CollinYan/HPV-2017-EE/Mechanical/brake actuation/20171115_224807.jpg

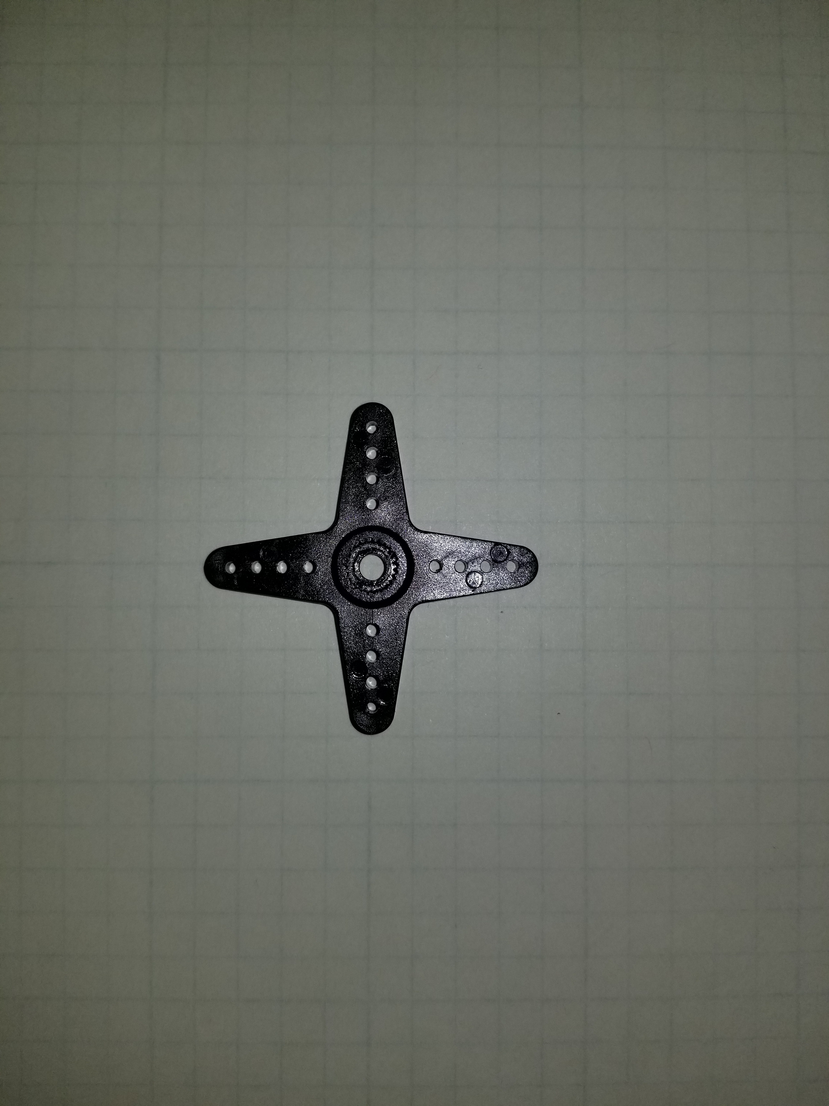
Mechanical/brake actuation/20171115_224807.jpg
