CollinYan/HPV-2017-EE/block diagram distributed power.docx

Battery

E-stop

Lever Lock

Tilt Lever

Brake Lever

Tilt-Lock

6V Buck

Rear Brakes

3.7V Buck

6V Buck

Arduino
