CollinYan/HPV-2017-EE/block diagram.docx

6V Buck

Battery

3.7V Buck

Lever Lock

Arduino

E-stop

Tilt-Lock

Tilt Lever

Rear Brakes

Brake Lever
