CollinYan/HPV-2017-EE/Breadboard_Template.pdf

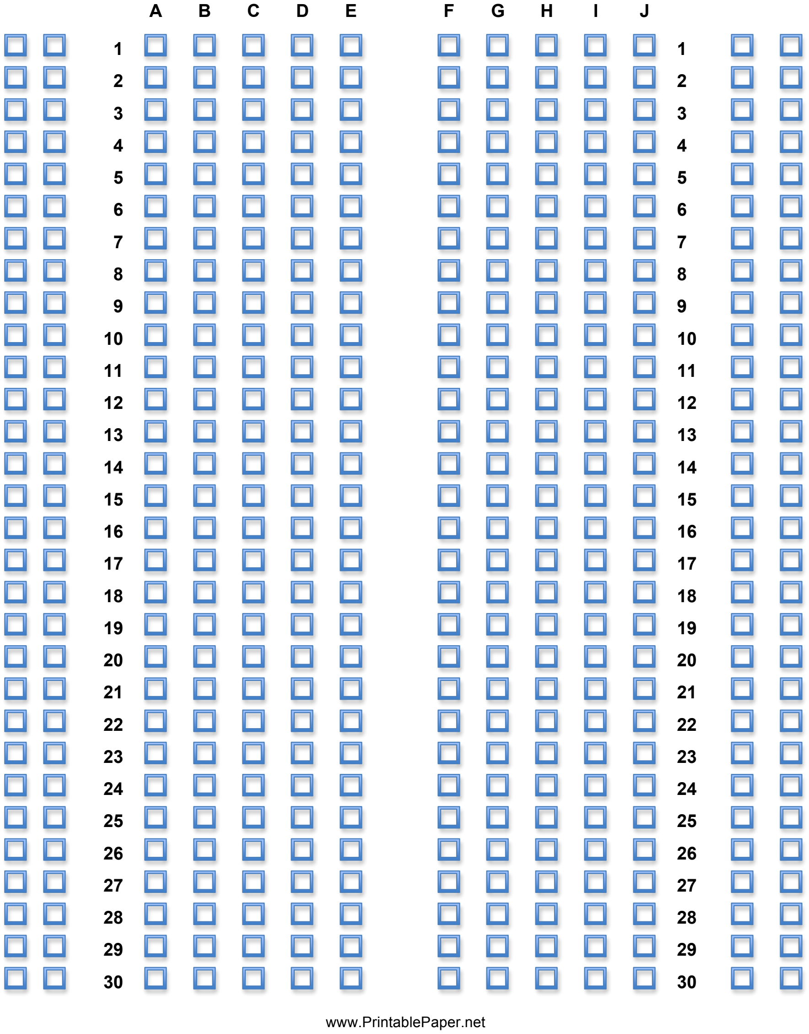
[picture p4: page 1]

A | B | C | D | E | F | G | H | I | J

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
10 10
11 11
12 12
13 13
14 14
15 15
16 16
17 17
18 18
19 19
20 20
21 21
22 22
23 23
24 24
25 25
26 26
27 27
28 28
29 29
30 30

www.PrintablePaper.net
