CollinYan/HPV-2017-EE/Code/README.docx

Go to preferences, and change sketchbook locatain to the dropbox folder

We can now keep all our libraries together

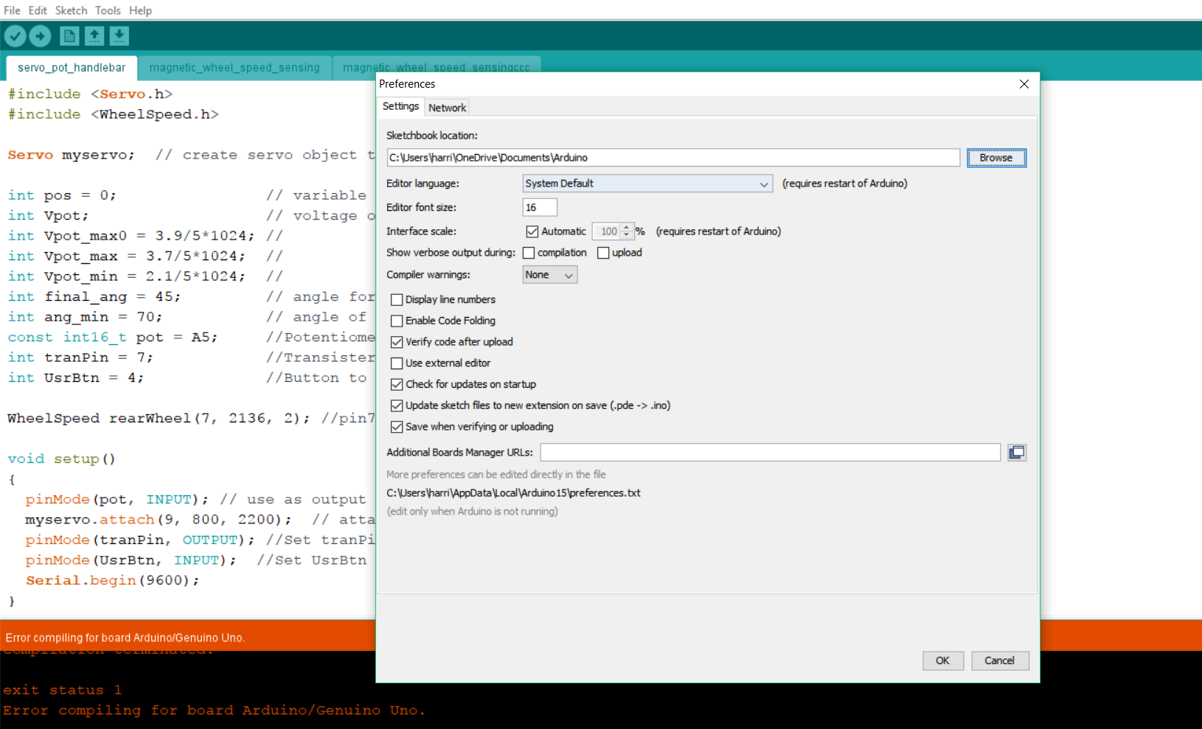
[picture p5: figure]

Change to:

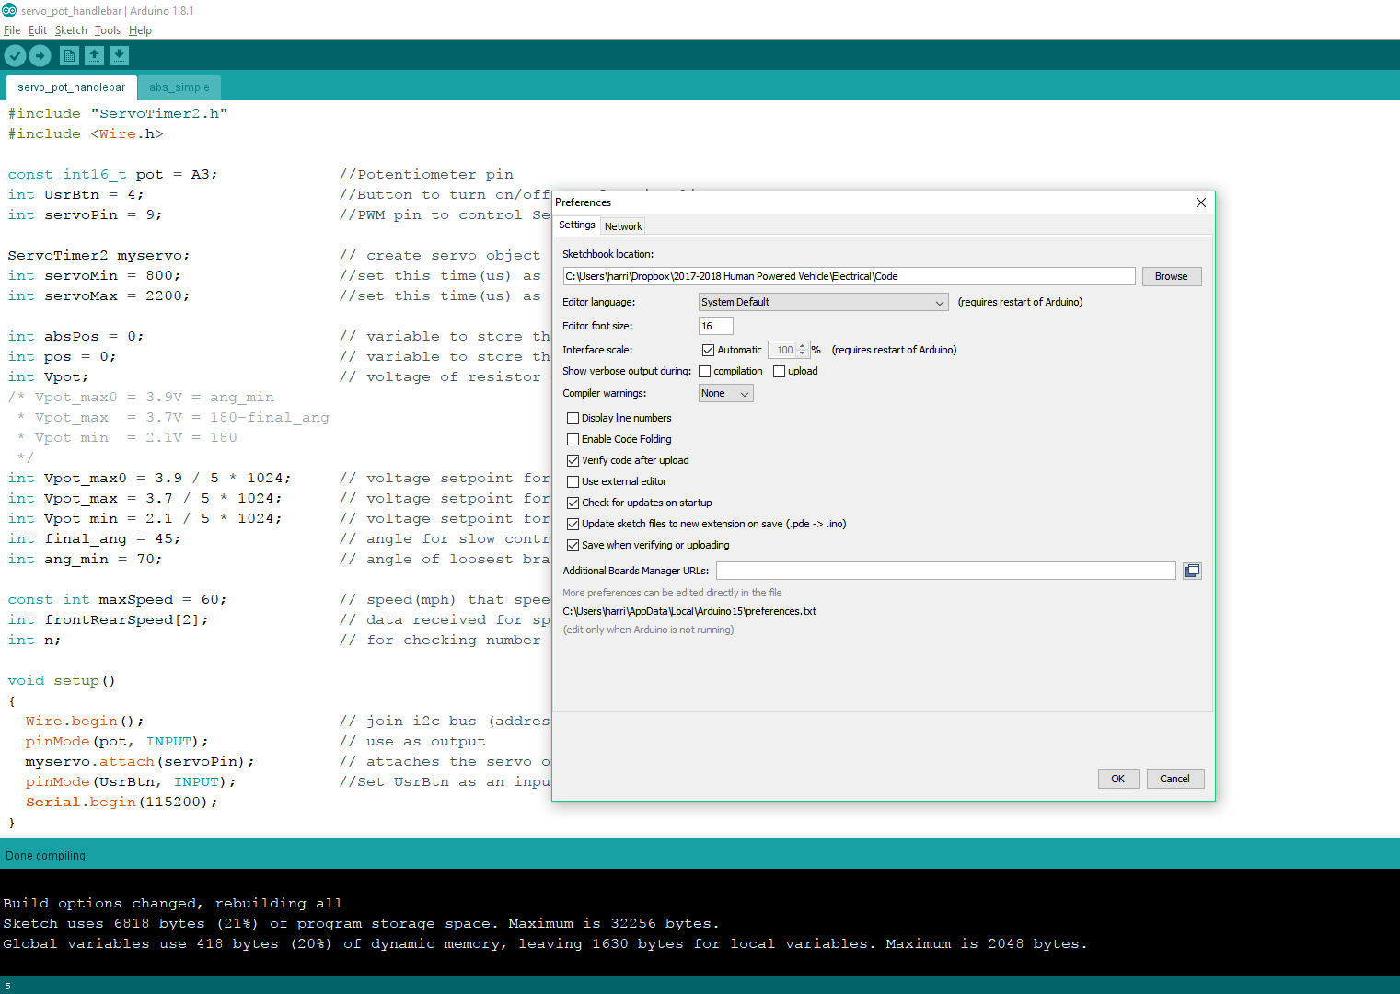
[picture p6: figure]
