CollinYan/HPV-2017-EE/data/16 magnets rear high speed.png

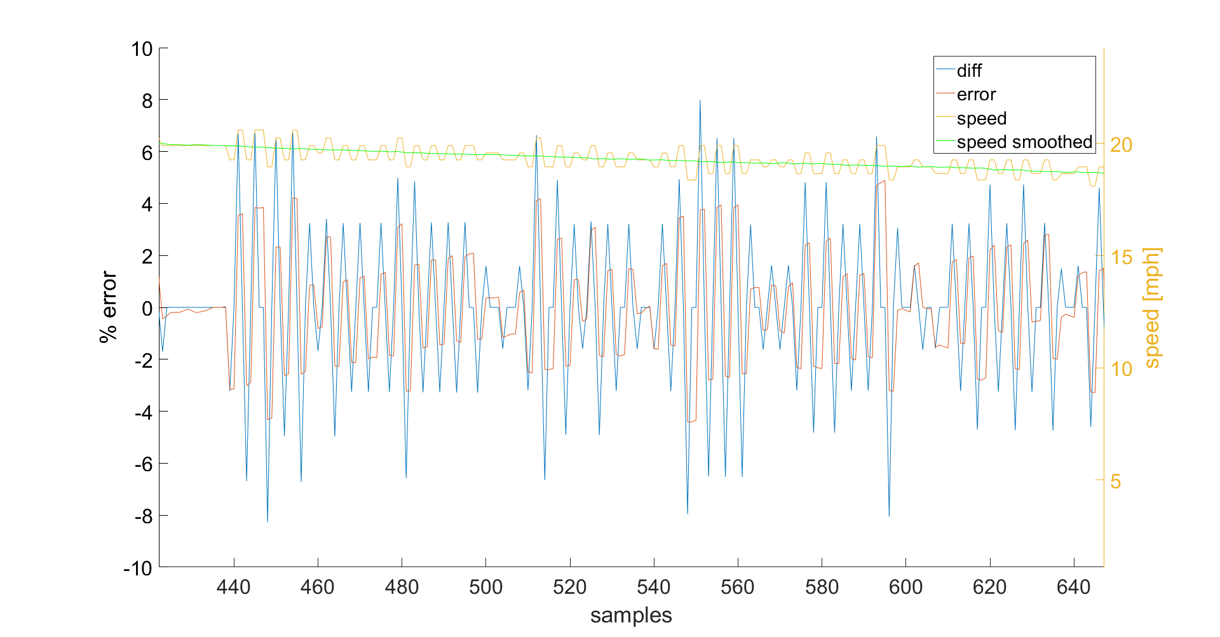
data/16 magnets rear high speed.png
