CollinYan/HPV-2017-EE/data/16 magnets rear low speed.png

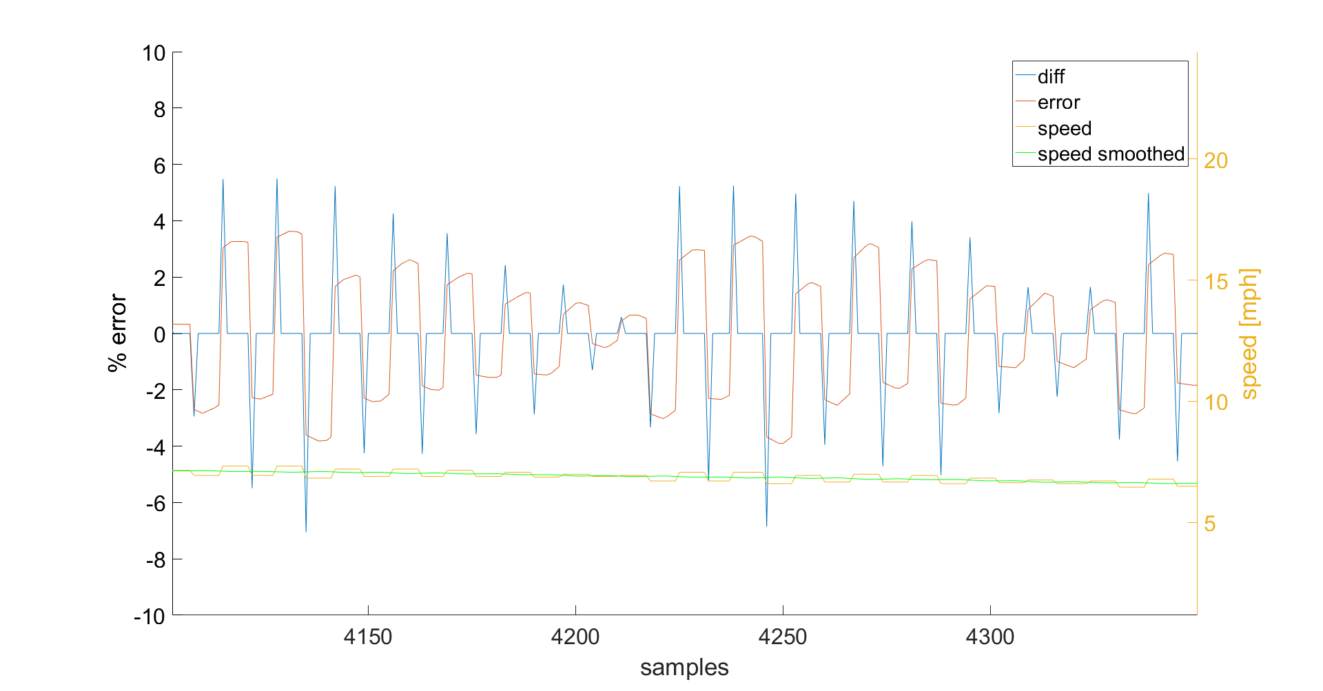
data/16 magnets rear low speed.png
