CollinYan/HPV-2017-EE/data/16 magnets rear.png

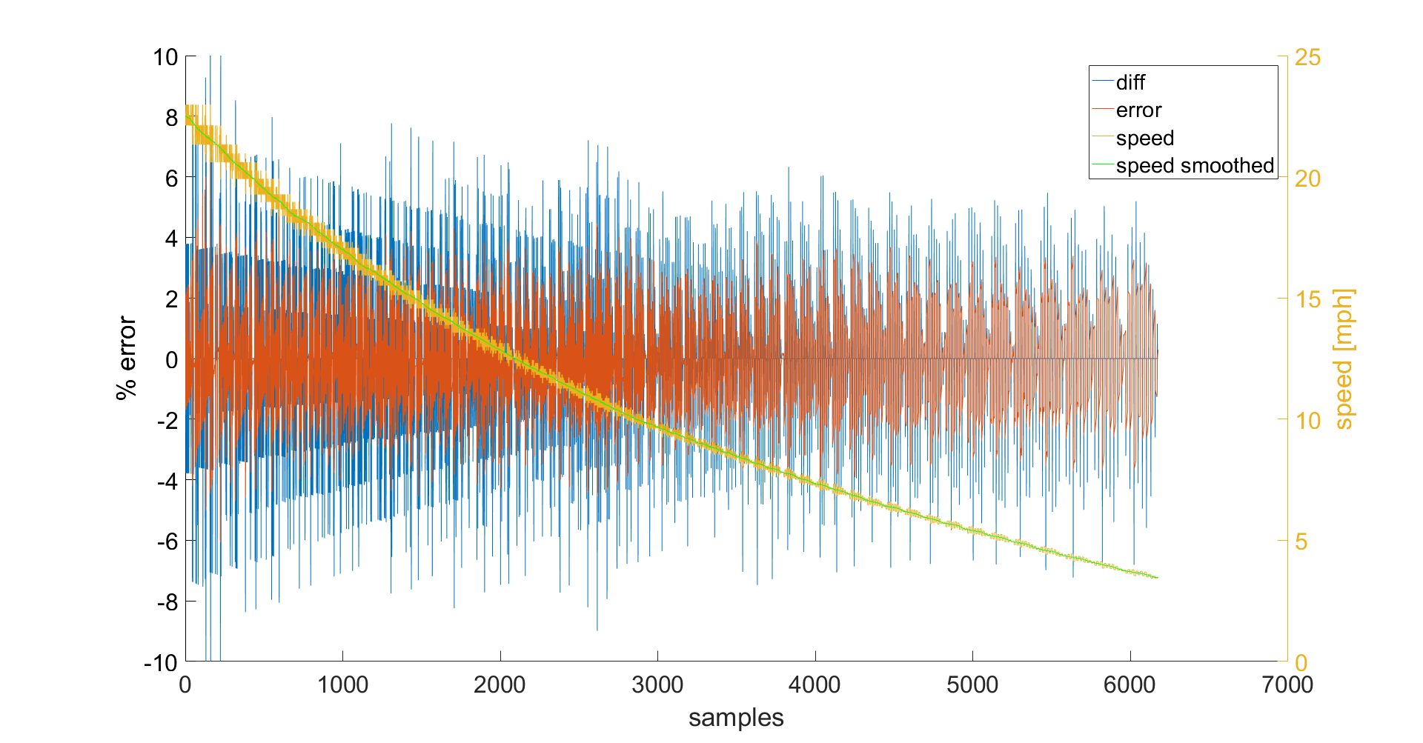
data/16 magnets rear.png
