CollinYan/HPV-2017-EE/PCB/smallerArduino101/images/layout.png

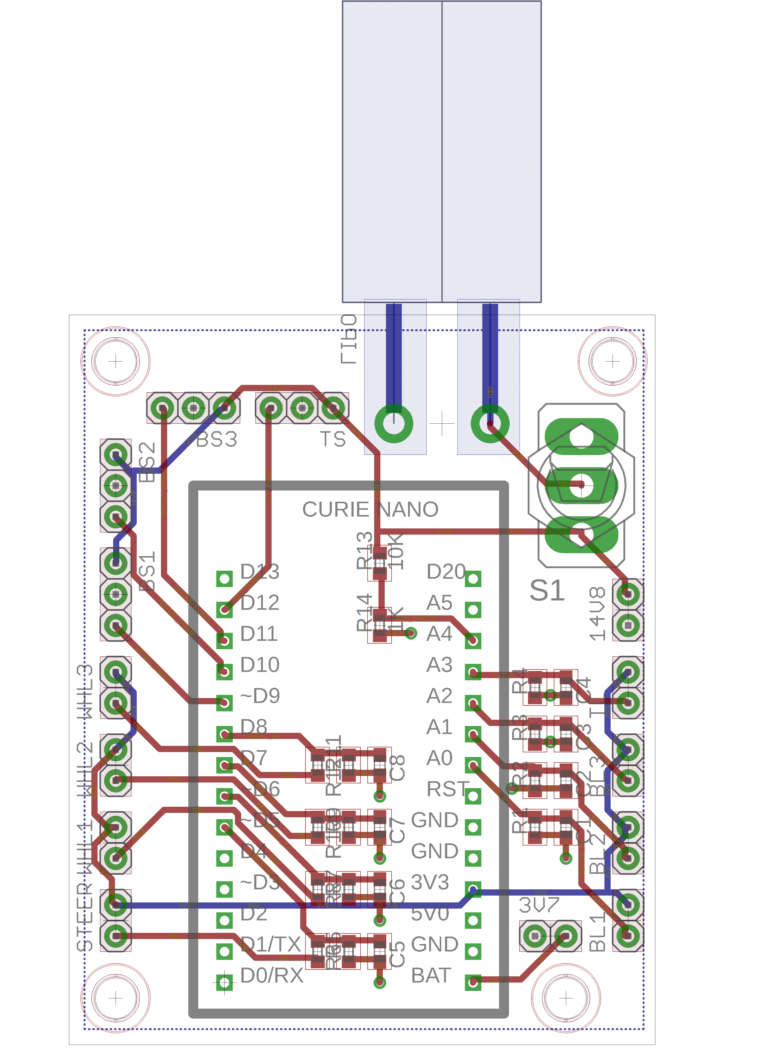
PCB/smallerArduino101/images/layout.png
