CollinYan/HPV-2017-EE/PCB/smallerArduino101/images/schem.png

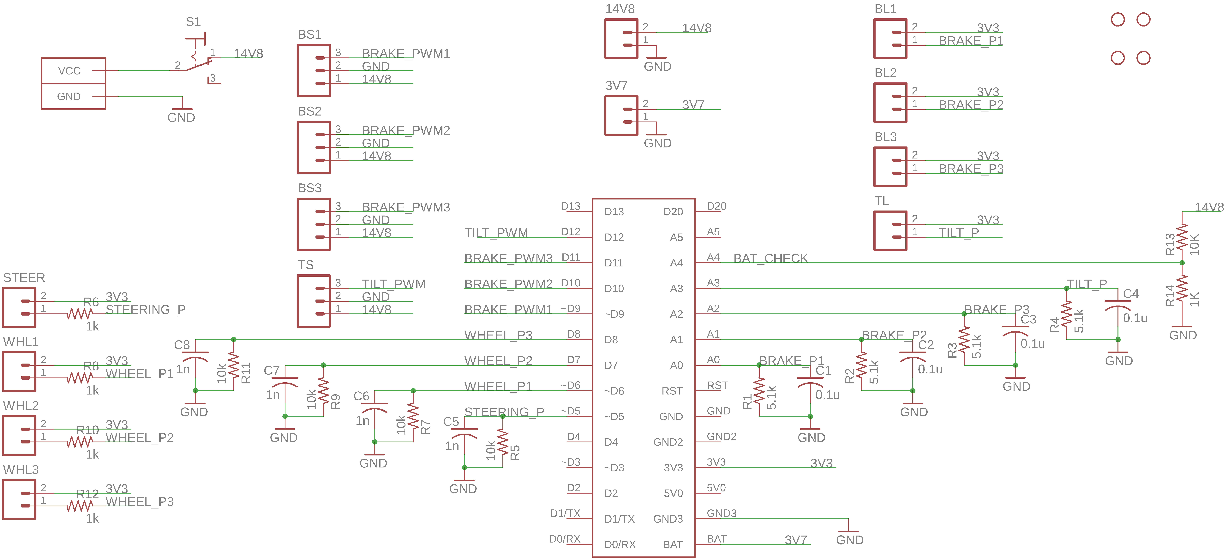
PCB/smallerArduino101/images/schem.png
