CollinYan/HPV-2017-EE/pics/cateye reed switch bounce_1.jpg

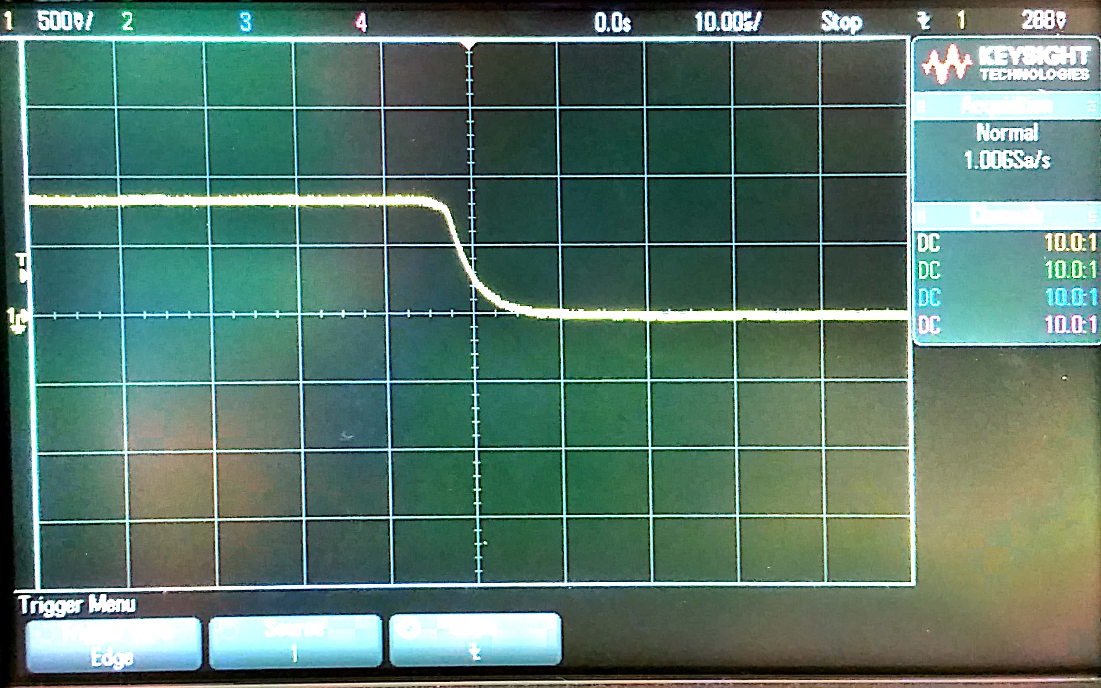
pics/cateye reed switch bounce_1.jpg
