CollinYan/HPV-2017-EE/pics/cateye reed switch bounce_2.jpg

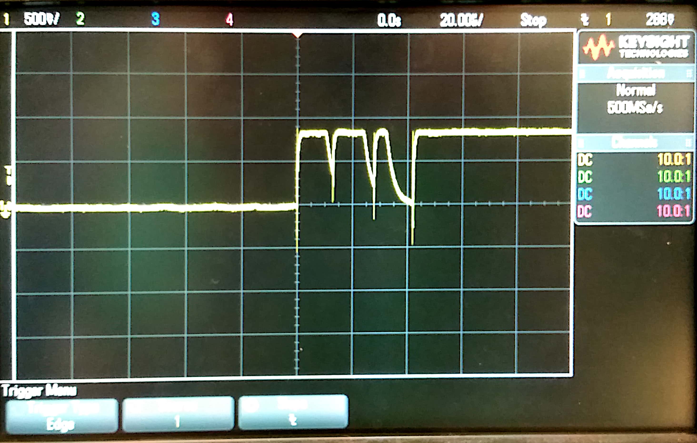
pics/cateye reed switch bounce_2.jpg
