CollinYan/HPV-2017-EE/pics/cateye reed switch bounce_3.jpg

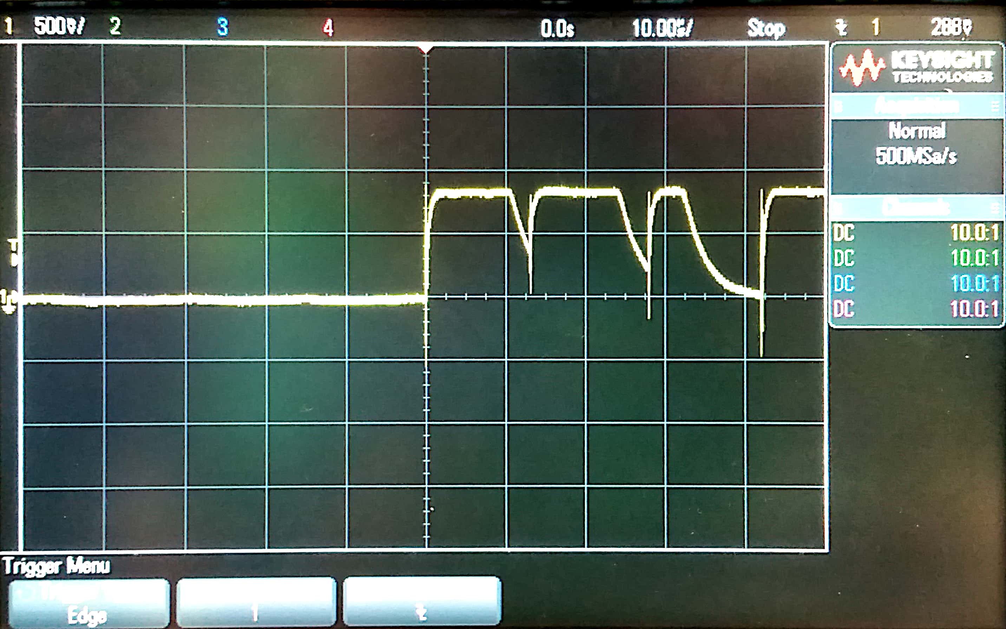
pics/cateye reed switch bounce_3.jpg
