CollinYan/HPV-2017-EE/pics/prototype disc.jpg

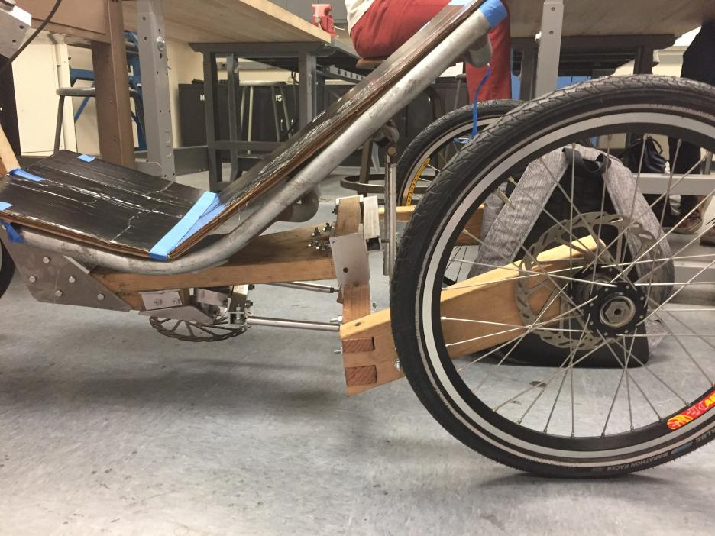
pics/prototype disc.jpg
