CollinYan/HPV-2017-EE/Mechanical/3dprint/brake lever p2.stl

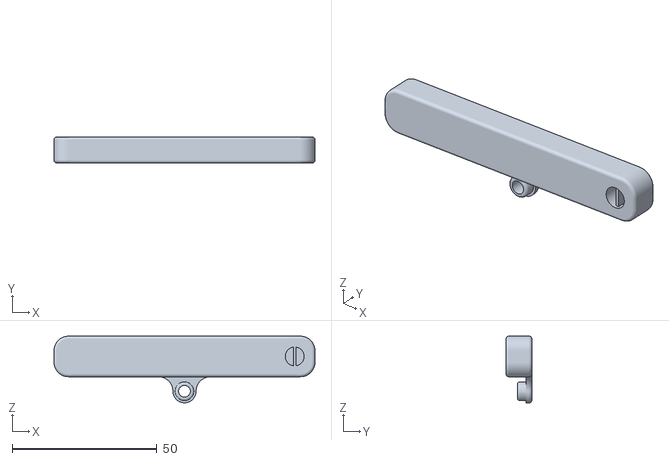
[picture p17: CAD file, 2018-02-09]
Mechanical/3dprint/brake lever p2.stl
90.0 x 9.00 x 23.0
