CollinYan/HPV-2017-EE/Mechanical/3dprint/kevin print feb 5/Enclosure.stl

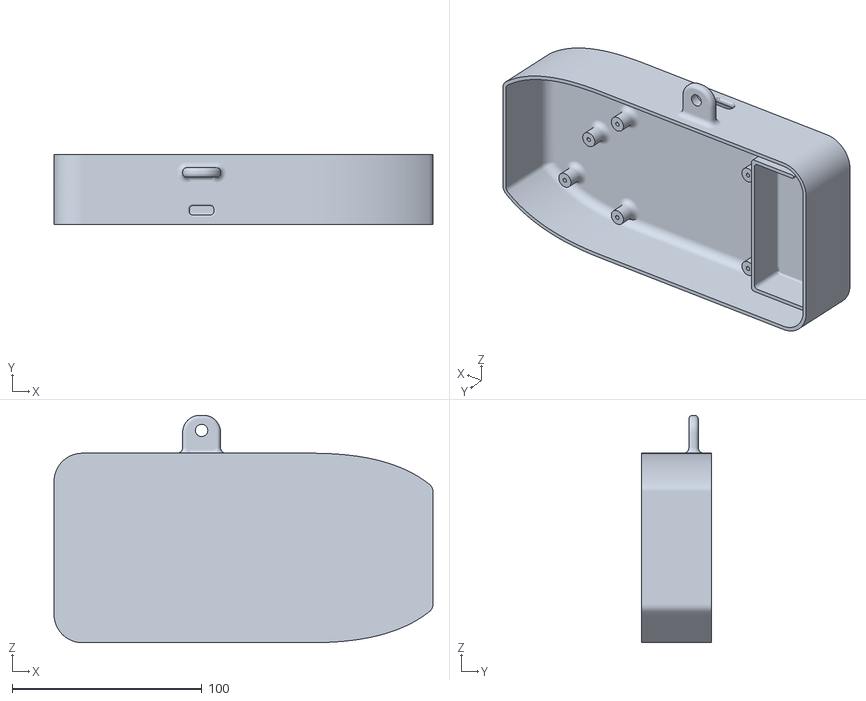
[picture p18: CAD file, 2018-02-09]
Mechanical/3dprint/kevin print feb 5/Enclosure.stl
200.0 x 37.0 x 120.0
