CollinYan/HPV-2017-EE/Mechanical/brake actuation/offset magnet.stl

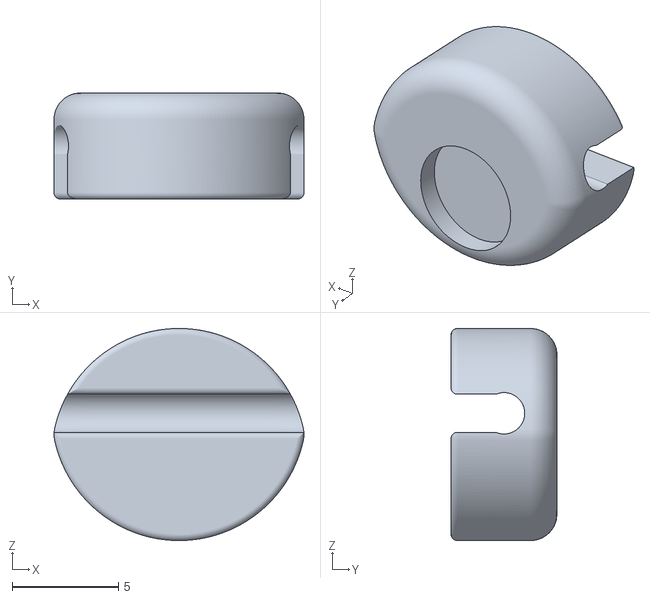
[picture p19: CAD file, 2018-03-03]
Mechanical/brake actuation/offset magnet.stl
11.8 x 5.00 x 10.00
