CollinYan/HPV-2017-EE/Mechanical/brake actuation/servo horn adaptor 20mm]/top horn adaptor.stl

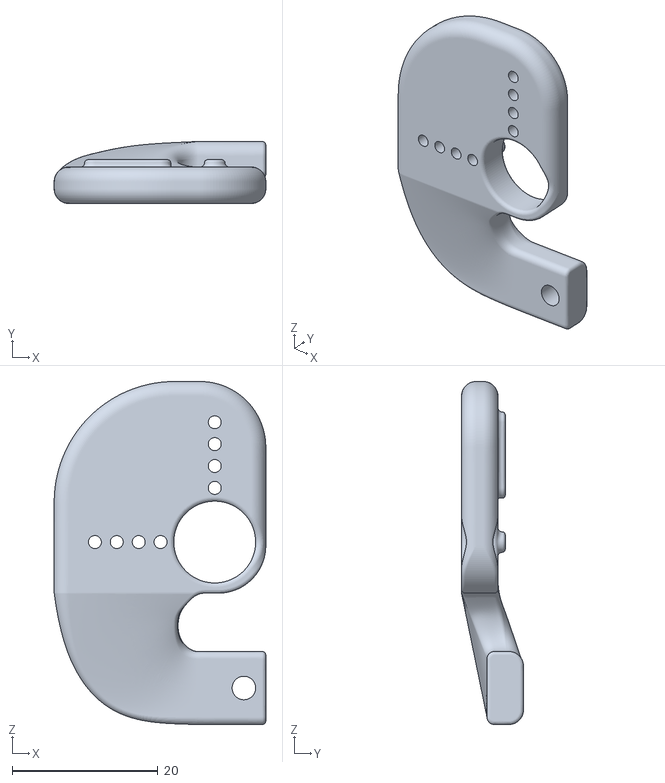
[picture p20: CAD file, 2018-03-02]
Mechanical/brake actuation/servo horn adaptor 20mm]/top horn adaptor.stl
29.0 x 8.50 x 47.0
