CollinYan/HPV-2017-EE/Mechanical/buck converter enclosure.stl

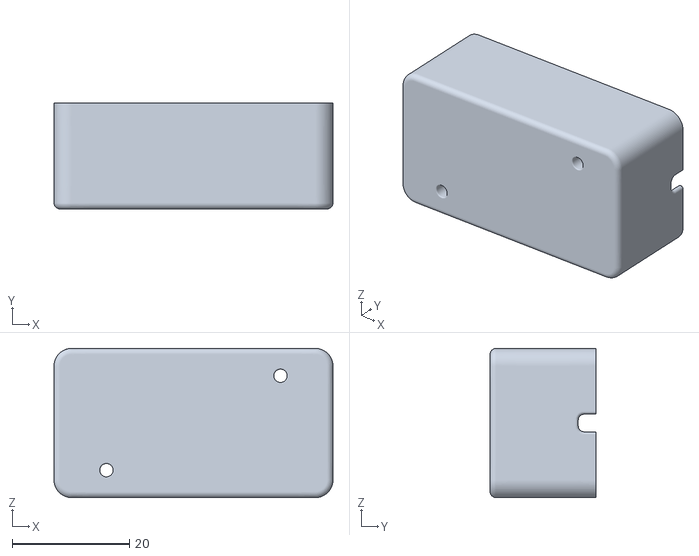
[picture p21: CAD file, 2018-02-27]
Mechanical/buck converter enclosure.stl
47.5 x 18.0 x 25.4
