CollinYan/HPV-2017-EE/Mechanical/3dprint/brake lever p1.stl

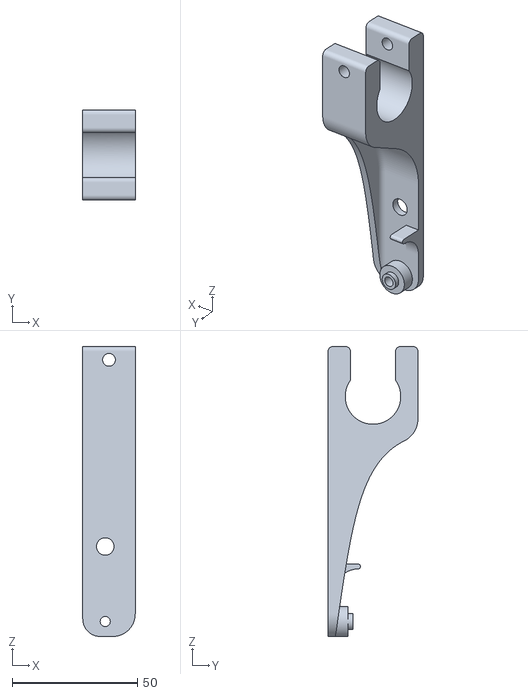
[picture p22: CAD file, 2018-02-09]
Mechanical/3dprint/brake lever p1.stl
21.0 x 36.0 x 116.0
