CollinYan/HPV-2017-EE/Mechanical/brake actuation/servo horn adaptor 20mm]/bottom horn adaptor.stl

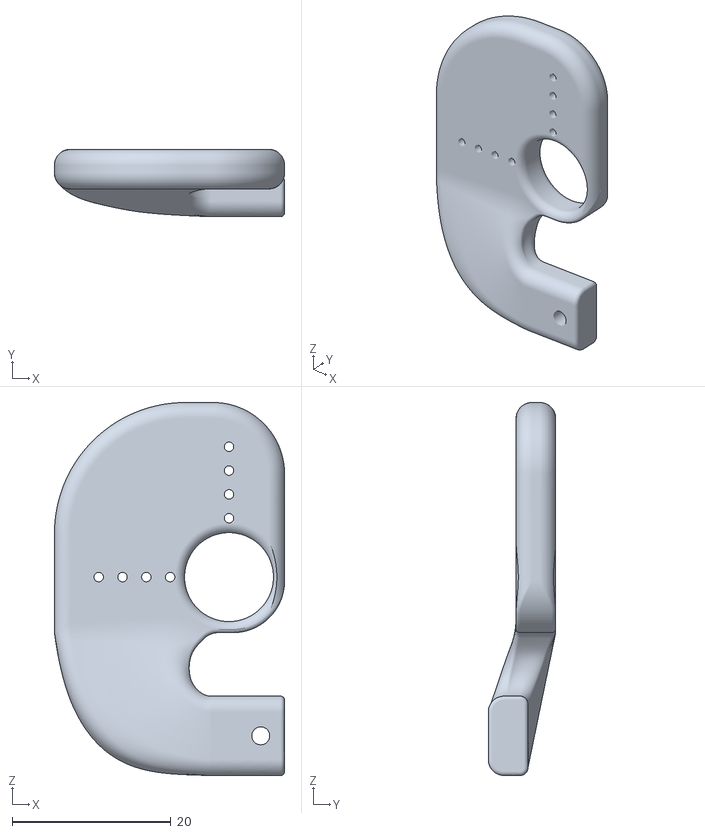
[picture p23: CAD file, 2018-03-02]
Mechanical/brake actuation/servo horn adaptor 20mm]/bottom horn adaptor.stl
29.0 x 8.50 x 47.0
