CollinYan/HPV-2017-EE/Mechanical/brake actuation/servo horn.STEP

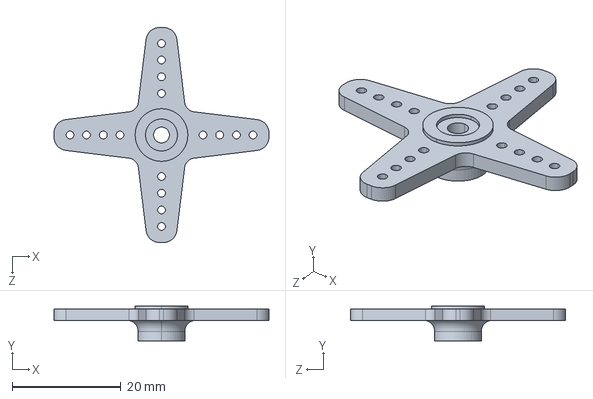
[picture p24: CAD file, 2018-01-30]
Mechanical/brake actuation/servo horn.STEP
39.6 x 6.43 x 39.6 mm
