CollinYan/HPV-2017-EE/Mechanical/buck converter enclosure lid.stl

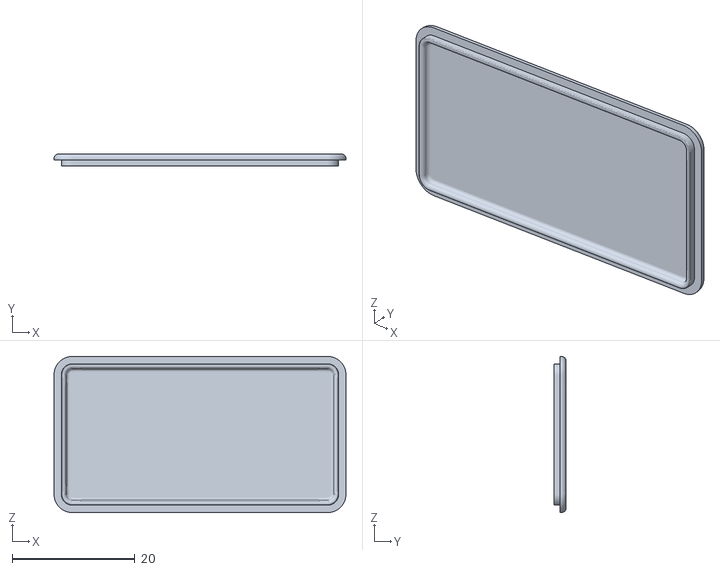
[picture p25: CAD file, 2018-02-27]
Mechanical/buck converter enclosure lid.stl
47.5 x 2.00 x 25.4
