CollinYan/HPV-2017-EE/Mechanical/3dprint/magnetholder v4.stl

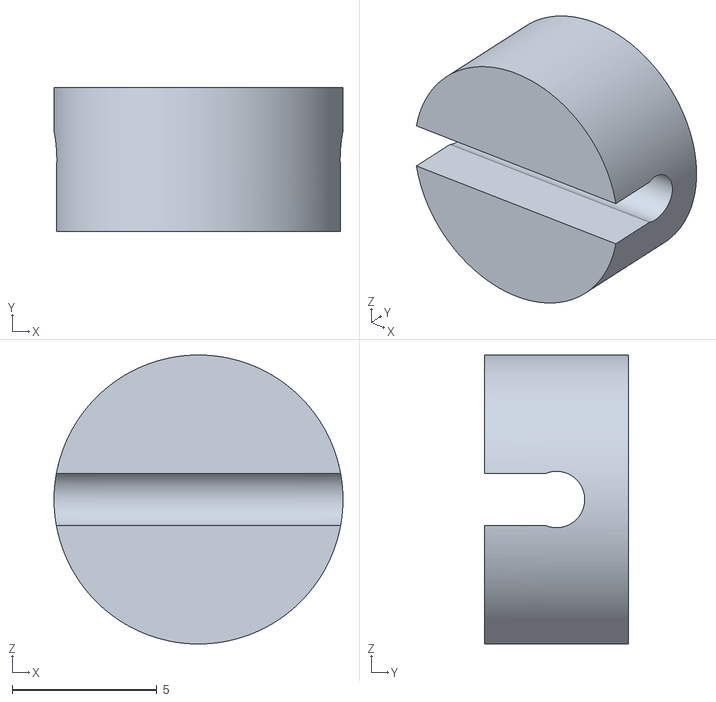
[picture p26: CAD file, 2018-01-30]
Mechanical/3dprint/magnetholder v4.stl
10.0 x 5.00 x 10.00
