CollinYan/HPV-2017-EE/Mechanical/brake actuation/new servo mount with coutnerbore for cory printing.stl

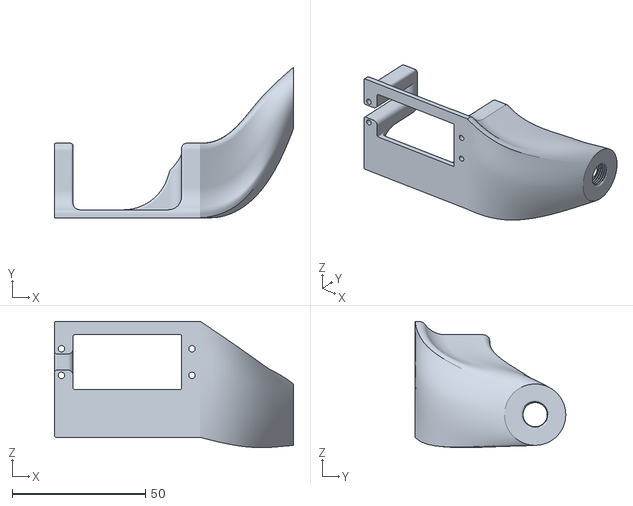
[picture p27: CAD file, 2018-01-30]
Mechanical/brake actuation/new servo mount with coutnerbore for cory printing.stl
89.7 x 56.5 x 47.4
