CollinYan/HPV-2017-EE/Mechanical/brake actuation/servo horn adaptor 20mm]/magnet holder.stl

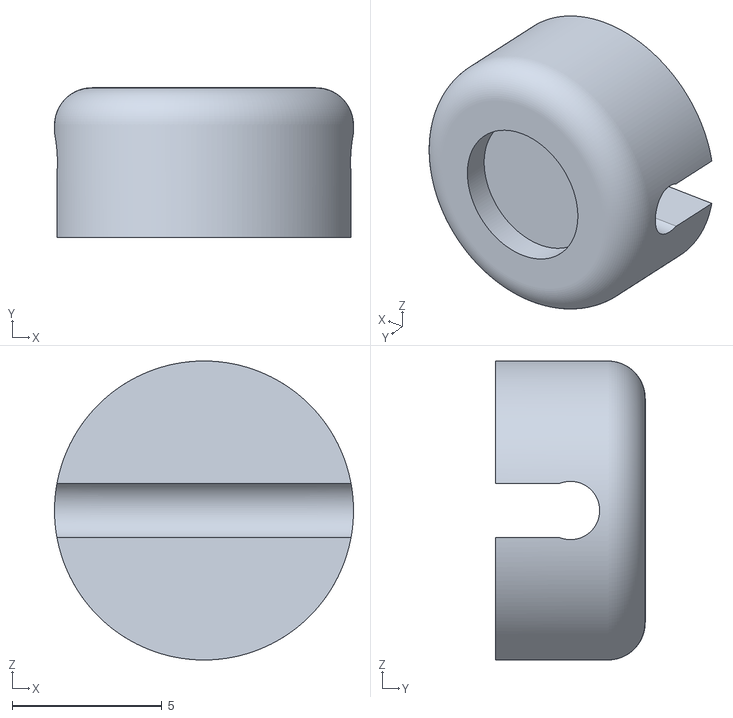
[picture p28: CAD file, 2018-03-02]
Mechanical/brake actuation/servo horn adaptor 20mm]/magnet holder.stl
10.0 x 5.00 x 10.00
