CollinYan/HPV-2017-EE/Mechanical/enclosure.stl

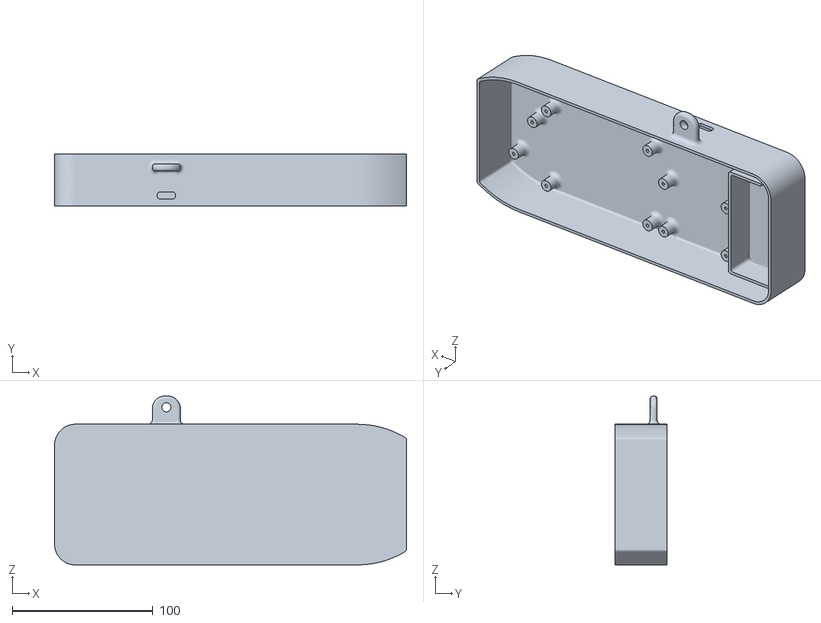
[picture p29: CAD file, 2018-02-09]
Mechanical/enclosure.stl
250.0 x 37.0 x 120.0
