CollinYan/HPV-2017-EE/Mechanical/3dprint/kevin print feb 5/Enclosure Lid.stl

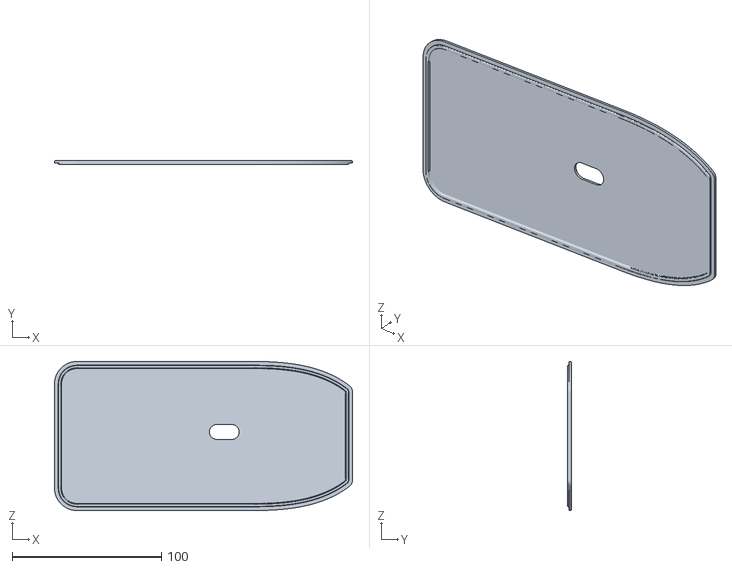
[picture p30: CAD file, 2018-02-09]
Mechanical/3dprint/kevin print feb 5/Enclosure Lid.stl
200.0 x 3.00 x 100.0
