CollinYan/HPV-2017-EE/Mechanical/brake actuation/servo.STEP

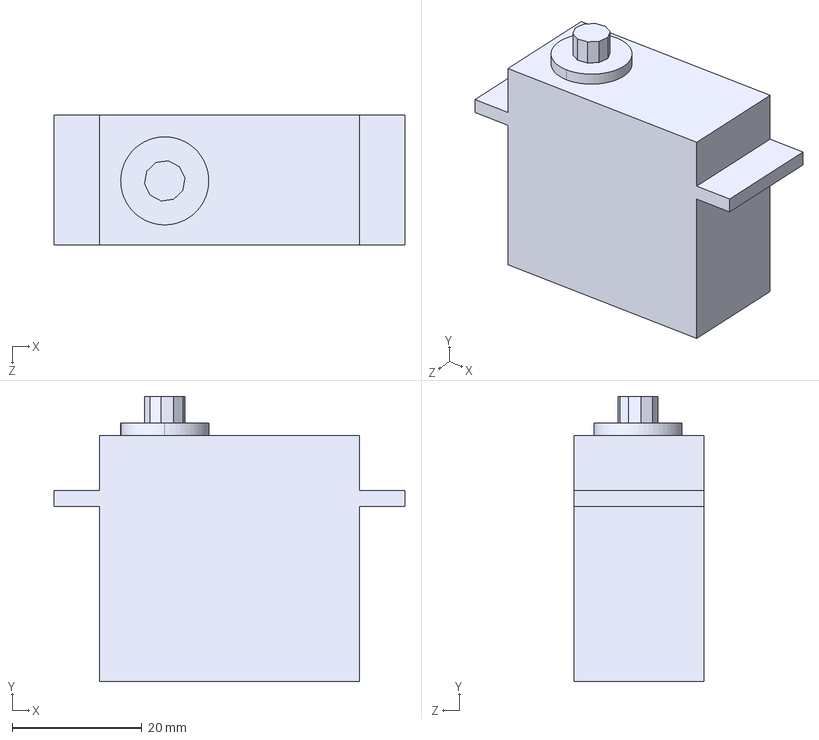
[picture p31: CAD file, 2018-01-30]
Mechanical/brake actuation/servo.STEP
54.2 x 44.0 x 20.0 mm
