CollinYan/HPV-2017-EE/Mechanical/pot holder 3.stl

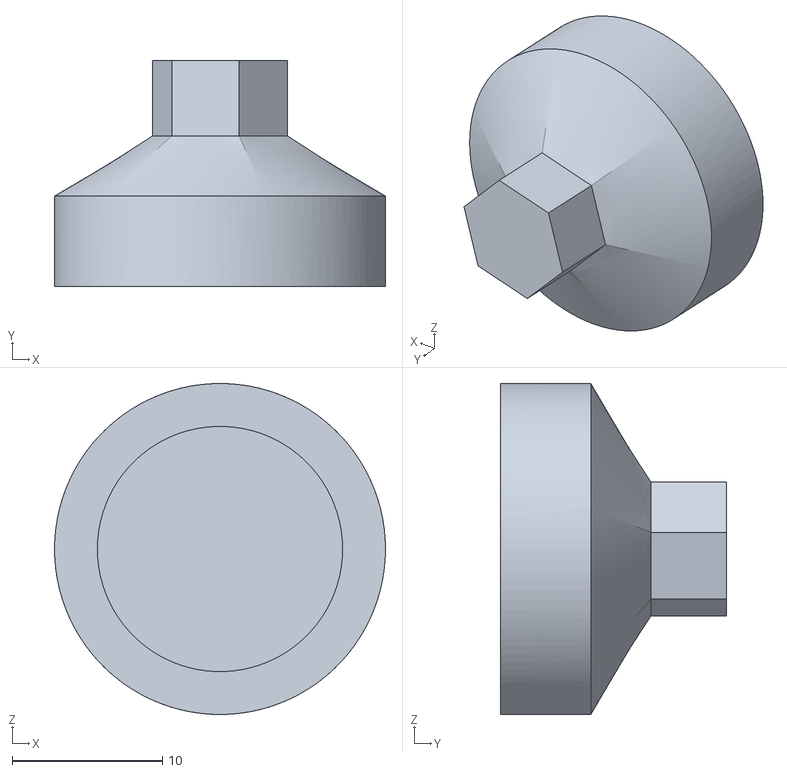
[picture p32: CAD file, 2018-01-30]
Mechanical/pot holder 3.stl
22.0 x 15.0 x 22.0
