CollinYan/HPV-2017-EE/Mechanical/brake actuation/top smooth hook adaptor.stl

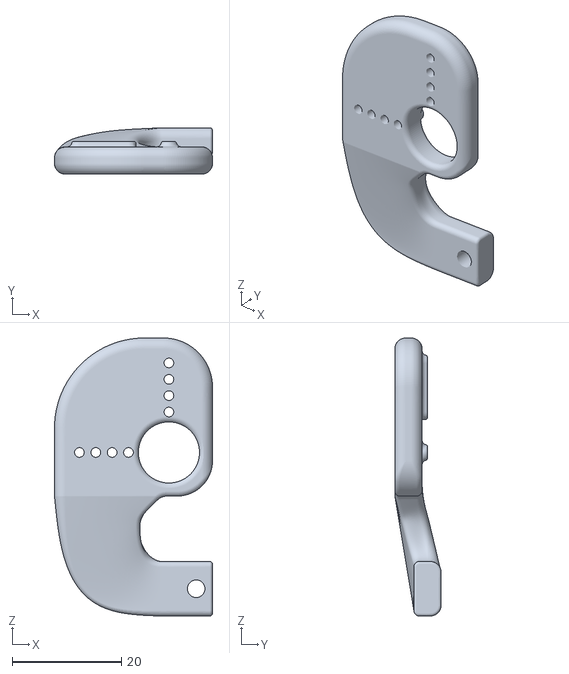
[picture p33: CAD file, 2018-01-30]
Mechanical/brake actuation/top smooth hook adaptor.stl
29.0 x 8.50 x 51.0
