CollinYan/HPV-2017-EE/Mechanical/pot holder (1).amf

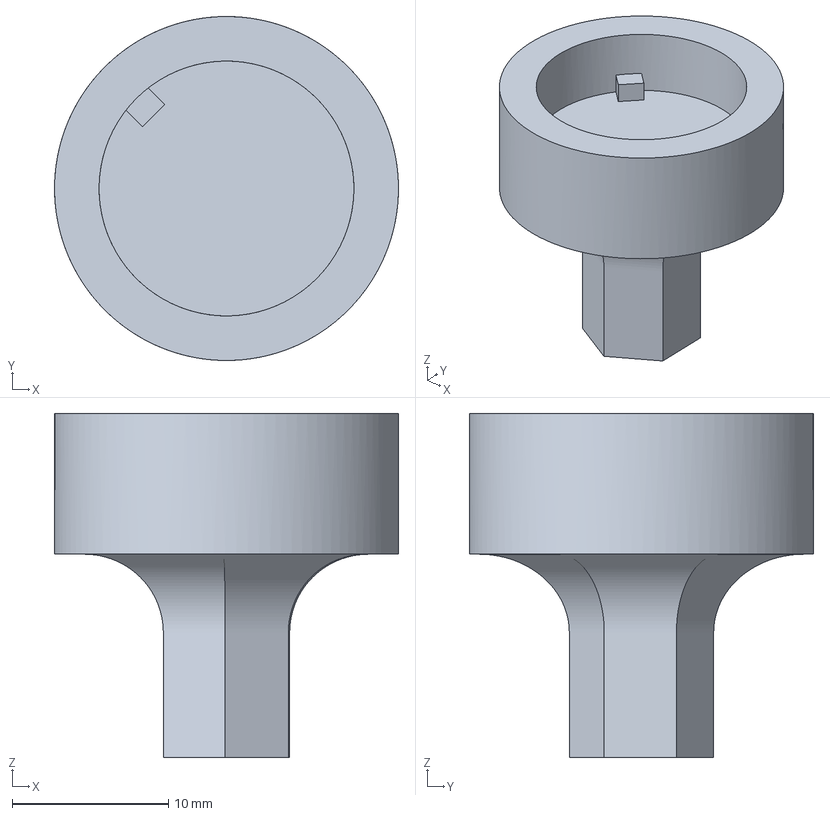
[picture p34: CAD file, 2018-01-30]
Mechanical/pot holder (1).amf
22.0 x 22.0 x 22.0 mm
