CollinYan/HPV-2017-EE/Mechanical/brake actuation/Body1.stl

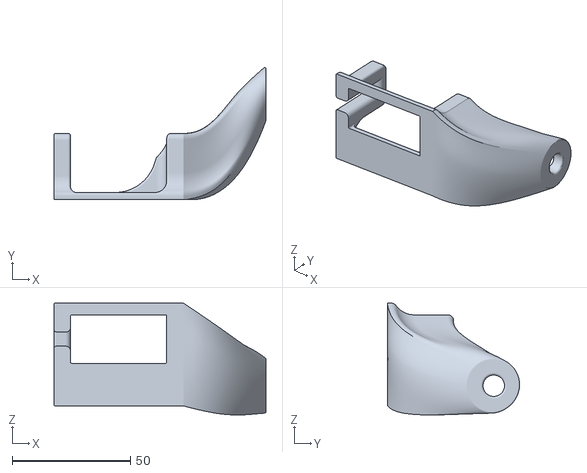
[picture p35: CAD file, 2018-01-30]
Mechanical/brake actuation/Body1.stl
89.7 x 55.9 x 47.4
