CollinYan/HPV-2017-EE/Mechanical/pot holder 2.stl

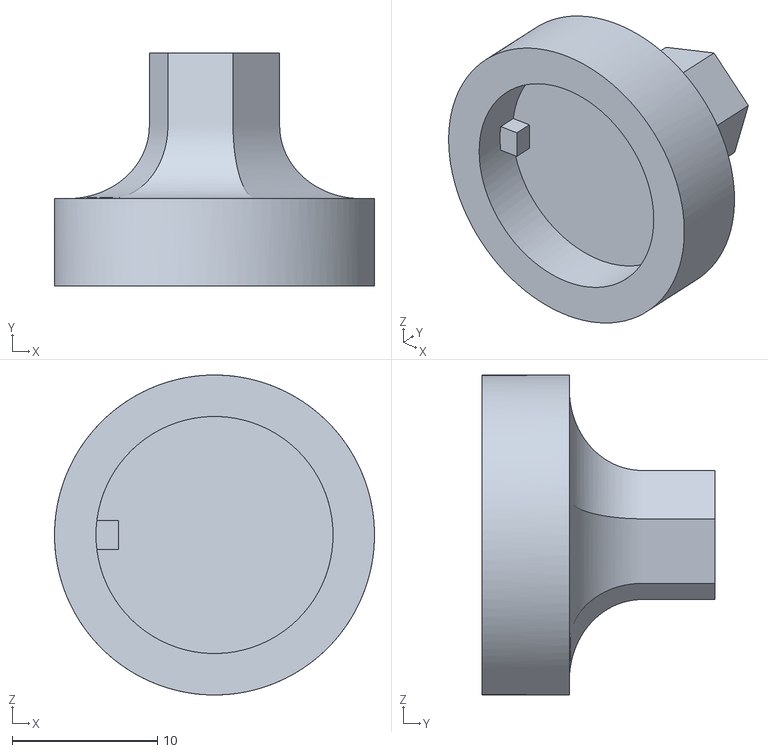
[picture p36: CAD file, 2018-01-30]
Mechanical/pot holder 2.stl
22.0 x 16.0 x 22.0
