CollinYan/HPV-2017-EE/Mechanical/brake actuation/cable attach.STEP

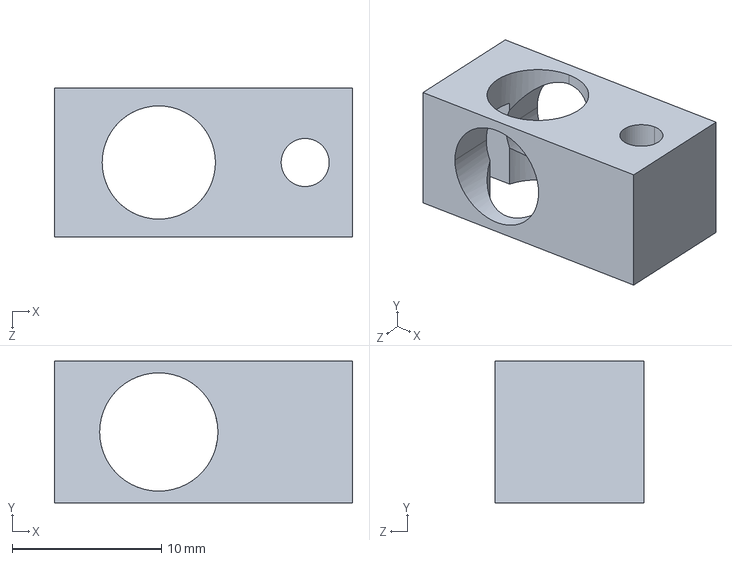
[picture p38: CAD file, 2018-01-30]
Mechanical/brake actuation/cable attach.STEP
20.0 x 9.53 x 10.0 mm
