CollinYan/HPV-2017-EE/Mechanical/brake actuation/servo horn adaptor bottom.STEP

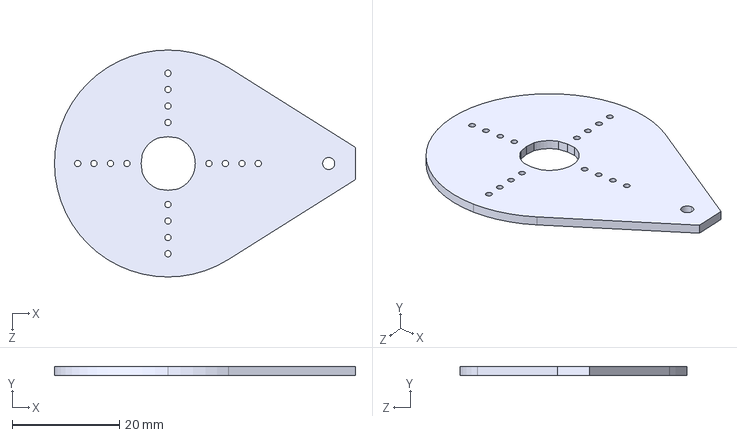
[picture p39: CAD file, 2018-01-30]
Mechanical/brake actuation/servo horn adaptor bottom.STEP
56.2 x 1.59 x 42.3 mm
