CollinYan/HPV-2017-EE/Mechanical/brake actuation/servo_mount2.STEP

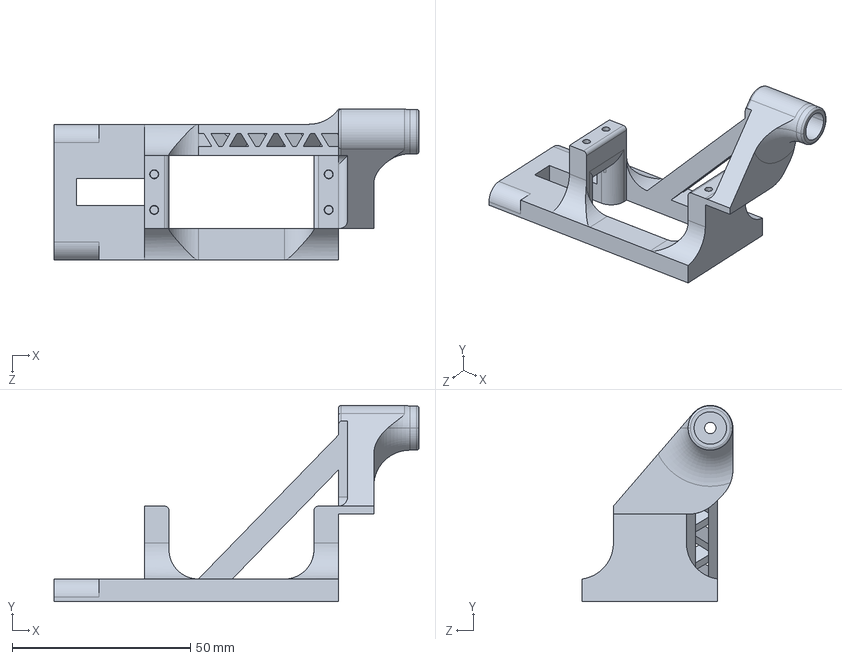
[picture p40: CAD file, 2018-01-30]
Mechanical/brake actuation/servo_mount2.STEP
102.5 x 55.1 x 42.4 mm
