CollinYan/HPV-2017-EE/Mechanical/brake actuation/bottom smooth hook adaptor.stl

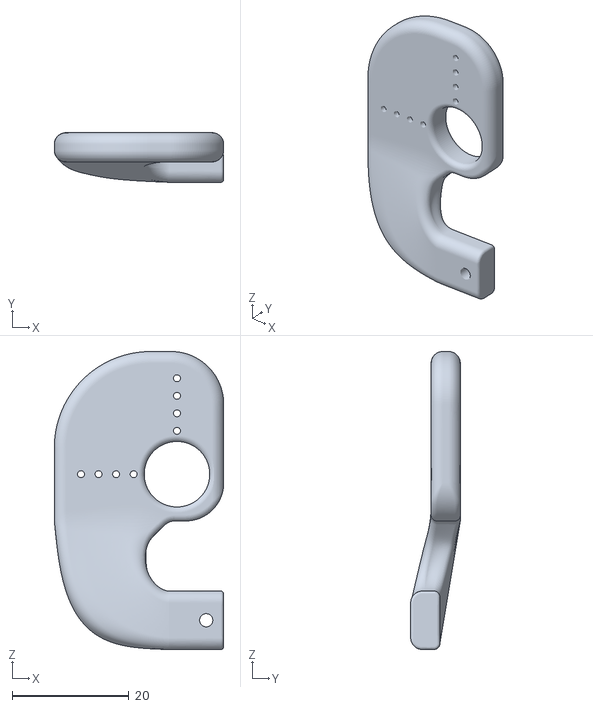
[picture p41: CAD file, 2018-01-30]
Mechanical/brake actuation/bottom smooth hook adaptor.stl
29.0 x 8.50 x 51.0
