CollinYan/HPV-2017-EE/Mechanical/brake actuation/Assem2.STEP

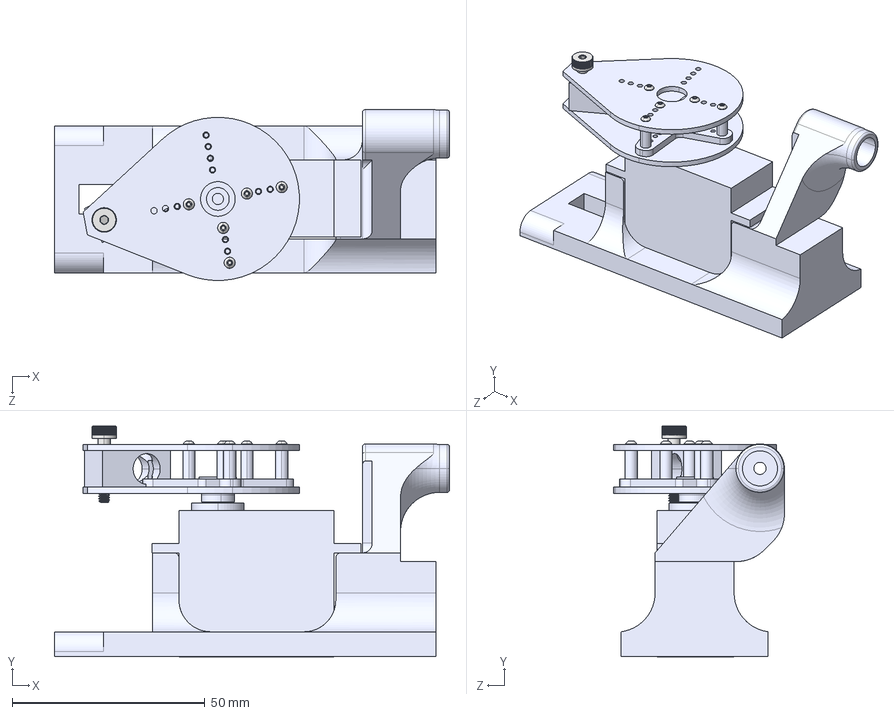
[picture p42: CAD file, 2018-01-30]
Mechanical/brake actuation/Assem2.STEP
102.5 x 59.9 x 44.4 mm
cable attach
servo
servo horn
servo horn adaptor bottom
servo hornt adaptor support columns x 5
servo horn adaptor top
0 80 bolt 0f5 long 91255A008_ALLOY STEEL BUTTON-HEAD SOCKET CAP SCREW_91255A008 x 5
1f8 diameter 0f5 long shoulder bolt 4 40 91259A157_ALLOY STEEL SHOULDER SCREW_91259A157
servo_mount
