CollinYan/HPV-2017-EE/Mechanical/brake actuation/barrel adjuster repalcemetn.stl

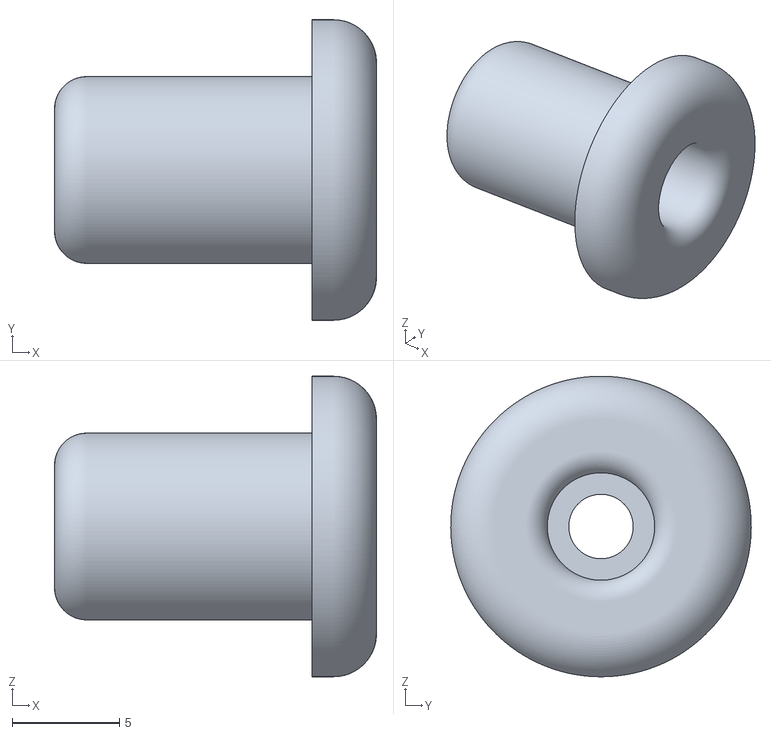
[picture p43: CAD file, 2018-01-30]
Mechanical/brake actuation/barrel adjuster repalcemetn.stl
15.0 x 14.0 x 14.0
