CollinYan/HPV-2017-EE/Mechanical/brake actuation/8.5mm socket v3(1).iges

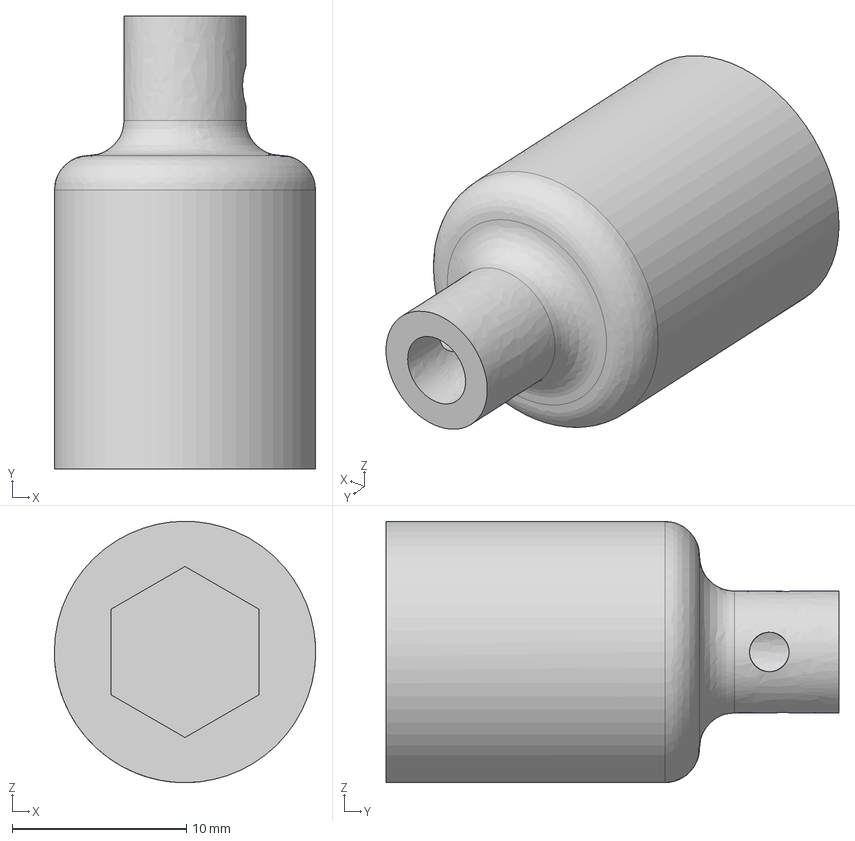
[picture p44: CAD file, 2018-01-30]
Mechanical/brake actuation/8.5mm socket v3(1).iges
15.0 x 26.0 x 15.0 mm
