CollinYan/HPV-2017-EE/(list of files, cad)

Other CAD files:
Mechanical/3dprint/kevin print feb 5/Brake Lever R1.stl
Mechanical/3dprint/kevin print feb 5/Brake Lever L2.stl
Mechanical/3dprint/kevin print feb 5/Brake Lever L1.stl
Mechanical/3dprint/kevin print feb 5/Brake Lever R2.stl
Mechanical/3dprint/magnetholder v5 5.15mm inner hole, fillet.stl
Mechanical/pot holder 3 (1).amf
Mechanical/brake actuation/without threads.stl
Mechanical/pot holder.stl
Mechanical/pot holder 2 (1).amf
Mechanical/brake actuation/new servo mount.stl
Mechanical/3dprint/magnetholder v1.stl
Mechanical/3dprint/magnetholder v2.stl
Mechanical/3dprint/magnetholder v3.stl
Mechanical/brake actuation/servo_mount.STL
