CollinYan/HPV-2017-EE/Code/WheelSpeedTest/data.xlsx

 | ticks | mph | ticks | mph | moving average | diff | %error | ticks | mph | moving average | diff | %error
1 | 68 | 0 | 9 | 0 | 0 | 0 | #DIV/0! | 0 | 0 | 0 | 0 | #DIV/0! | 0.03
2 | 68 | 0 | 9 | 0 | 0 | 0 | #DIV/0! | 0 | 0 | 0 | 0 | #DIV/0! | 0.03
3 | 0 | 0 | 9 | 0 | 0 | 0 | #DIV/0! | 0 | 0 | 0 | 0 | #DIV/0! | 0.68
 | 0 | 0 | 9 | 0 | 0 | 0 | #DIV/0! | 0 | 0 | 0 | 0 | #DIV/0! | 0.68
 | 0 | 0 | 9 | 0 | 0 | 0 | #DIV/0! | 0 | 0 | 0 | 0 | #DIV/0! | 0.73
 | 0 | 0 | 9 | 0 | 0 | 0 | #DIV/0! | 0 | 0 | 0 | 0 | #DIV/0! | 0.73
 | 0 | 0 | 9 | 0 | 0 | 0 | #DIV/0! | 0 | 0 | 0 | 0 | #DIV/0! | 1.59
 | 0 | 0 | 9 | 0 | 0 | 0 | #DIV/0! | 0 | 0 | 0 | 0 | #DIV/0! | 1.59
 | 0 | 0 | 9 | 0 | 0 | 0 | #DIV/0! | 0 | 0 | 0 | 0 | #DIV/0! | 1.47
 | 0 | 0 | 9 | 0 | 0 | 0 | #DIV/0! | 0 | 0 | 0 | 0 | #DIV/0! | 1.47
 | 0 | 0 | 9 | 0 | 0 | 0 | #DIV/0! | 0 | 0 | 0 | 0 | #DIV/0! | 1.34
 | 0 | 0 | 9 | 0 | 0 | 0 | #DIV/0! | 0 | 0 | 0 | 0 | #DIV/0! | 1.34
 | 0 | 0 | 9 | 0 | 0 | 0 | #DIV/0! | 0 | 0 | 0 | 0 | #DIV/0! | 1.24
 | 0 | 0 | 9 | 0 | 0 | 0 | #DIV/0! | 0 | 0 | 0 | 0 | #DIV/0! | 1.24
 | 0 | 0 | 9 | 0 | 0 | 0 | #DIV/0! | 0 | 0 | 0 | 0 | #DIV/0! | 1.09
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
