CollinYan/HPV-2017-EE/PCB/smallerArduino101/board1.brd

## EAGLE design PCB/smallerArduino101/board1.brd (2018-03-06)

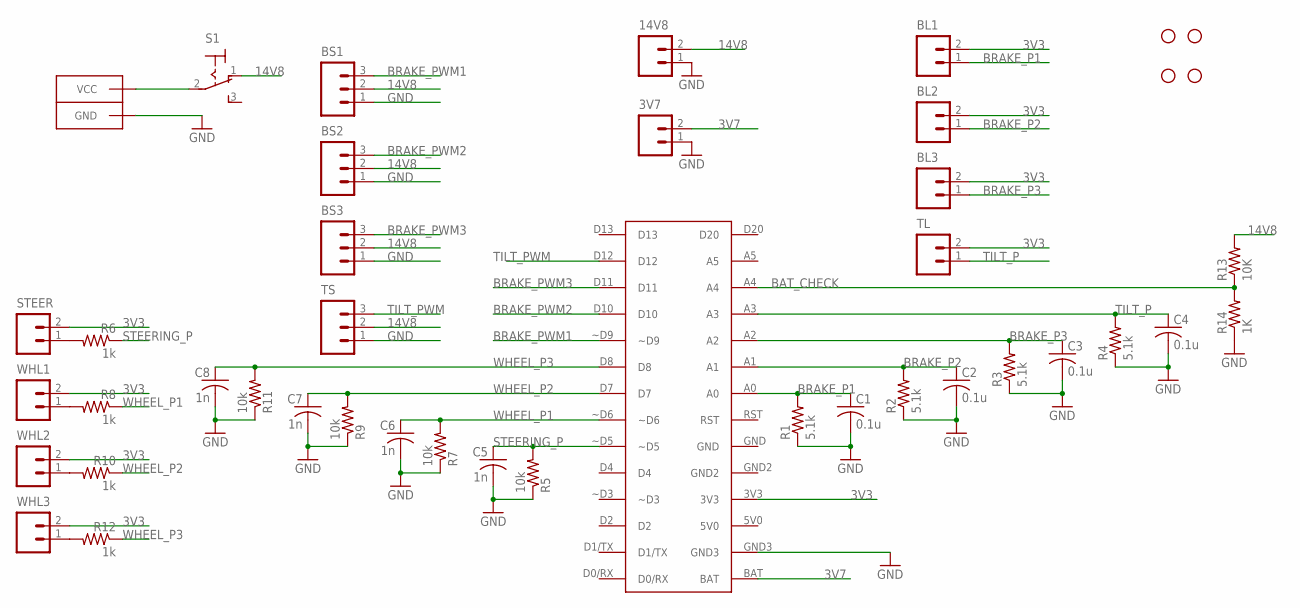
[picture p45: schematic board1.sch]

Parts:
3V7, 14V8: M02PTH; 1X02
BL1, BL2, BL3: M02PTH; 1X02
BS1, BS2, BS3: M03PTH; 1X03
C1, C2, C3, C4: 0.1u; C0603
C5, C6, C7, C8: 1n; C0603
JP13, JP14, JP15, JP16: STAND-OFF
LIPO: ANDERSONHORIZONTAL; ANDERSON_HORIZONTAL
R1, R2, R3, R4: 5.1k; R0603
R5, R7, R9, R11: 10k; R0603
R6, R8, R10, R12: 1k; R0603
R13: 10K; R0603
R14: 1K; R0603
S1: M9040P
STEER: M02PTH; 1X02
TL: M02PTH; 1X02
TS: M03PTH; 1X03
U$1: CURIENANO_BREAKOUT; CURIENANO
WHL1, WHL2, WHL3: M02PTH; 1X02

Connections:
3V3: BL1.2, BL2.2, BL3.2, STEER.2, TL.2, U$1.3V3, WHL1.2, WHL2.2, WHL3.2
3V7: 3V7.2, U$1.BAT
14V8: 14V8.2, BS1.2, BS2.2, BS3.2, R13.2, S1.1 (O), TS.2
BAT_CHECK: R13.1, R14.2, U$1.A4
BRAKE_P1: BL1.1, C1.1, R1.2, U$1.A0
BRAKE_P2: BL2.1, C2.1, R2.2, U$1.A1
BRAKE_P3: BL3.1, C3.1, R3.2, U$1.A2
BRAKE_PWM1: BS1.3, U$1.~D9
BRAKE_PWM2: BS2.3, U$1.D10
BRAKE_PWM3: BS3.3, U$1.D11
GND: 3V7.1, 14V8.1, BS1.1, BS2.1, BS3.1, C1.2, C2.2, C3.2, C4.2, C5.2, C6.2, C7.2, C8.2, LIPO.PIN1 (GND), LIPO.PIN1-LEAD (GND), R1.1, R2.1, R3.1, R4.1, R5.1, R7.1, R9.1, R11.1, R14.1, TS.1, U$1.GND3
unnamed: R6.2, STEER.1
unnamed: R8.2, WHL1.1
unnamed: R10.2, WHL2.1
unnamed: R12.2, WHL3.1
unnamed: LIPO.PIN2 (VCC), LIPO.PIN2-LEAD (VCC), S1.2
STEERING_P: C5.1, R5.2, R6.1, U$1.~D5
TILT_P: C4.1, R4.2, TL.1, U$1.A3
TILT_PWM: TS.3, U$1.D12
WHEEL_P1: C6.1, R7.2, R8.1, U$1.~D6
WHEEL_P2: C7.1, R9.2, R10.1, U$1.D7
WHEEL_P3: C8.1, R11.2, R12.1, U$1.D8

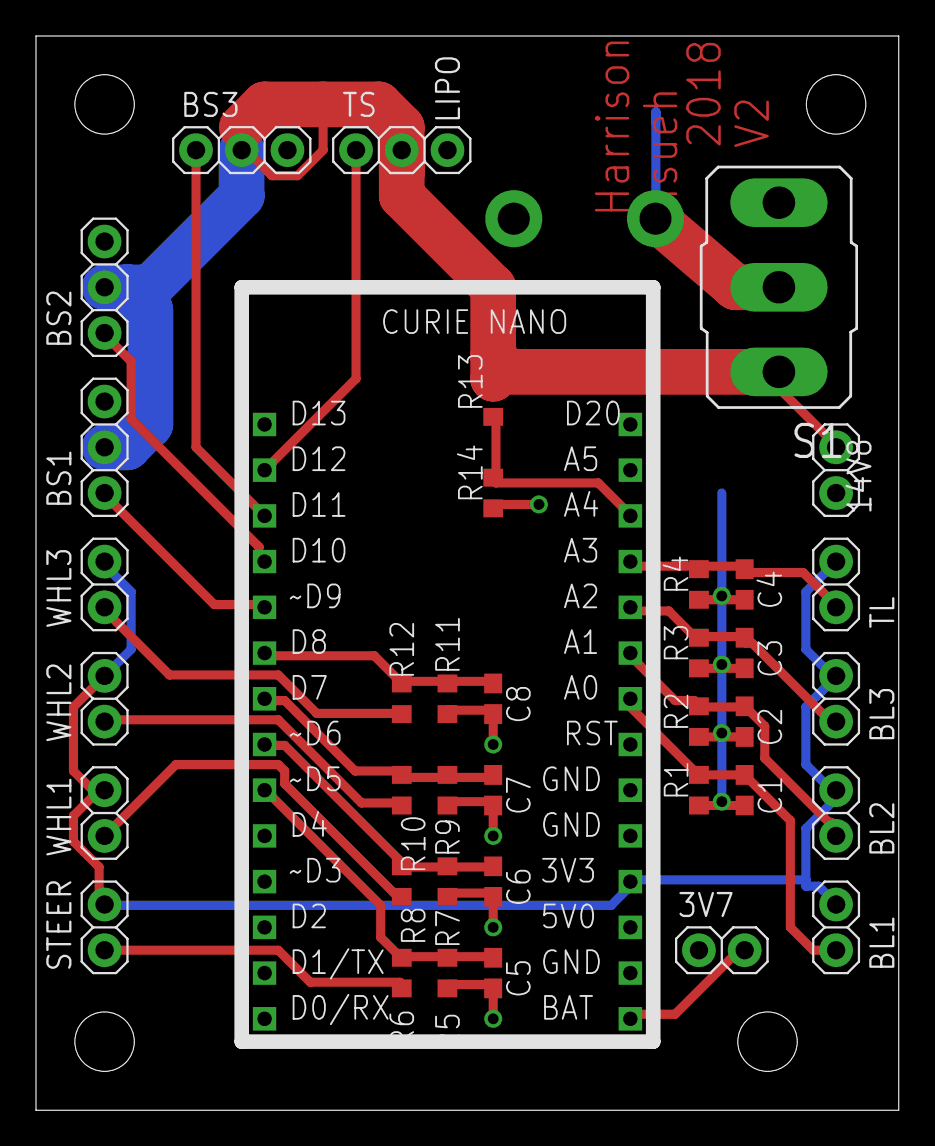
[picture p46: board PCB/smallerArduino101/board1.brd from above]

Board: 2 copper layers, 47.9 x 59.7 mm, 43 parts (1 on the bottom side), 22 nets.
