CollinYan/HPV-2017-EE/PCB/smallerArduino101/boarddoubled.brd

## EAGLE design PCB/smallerArduino101/boarddoubled.brd (2018-02-22)

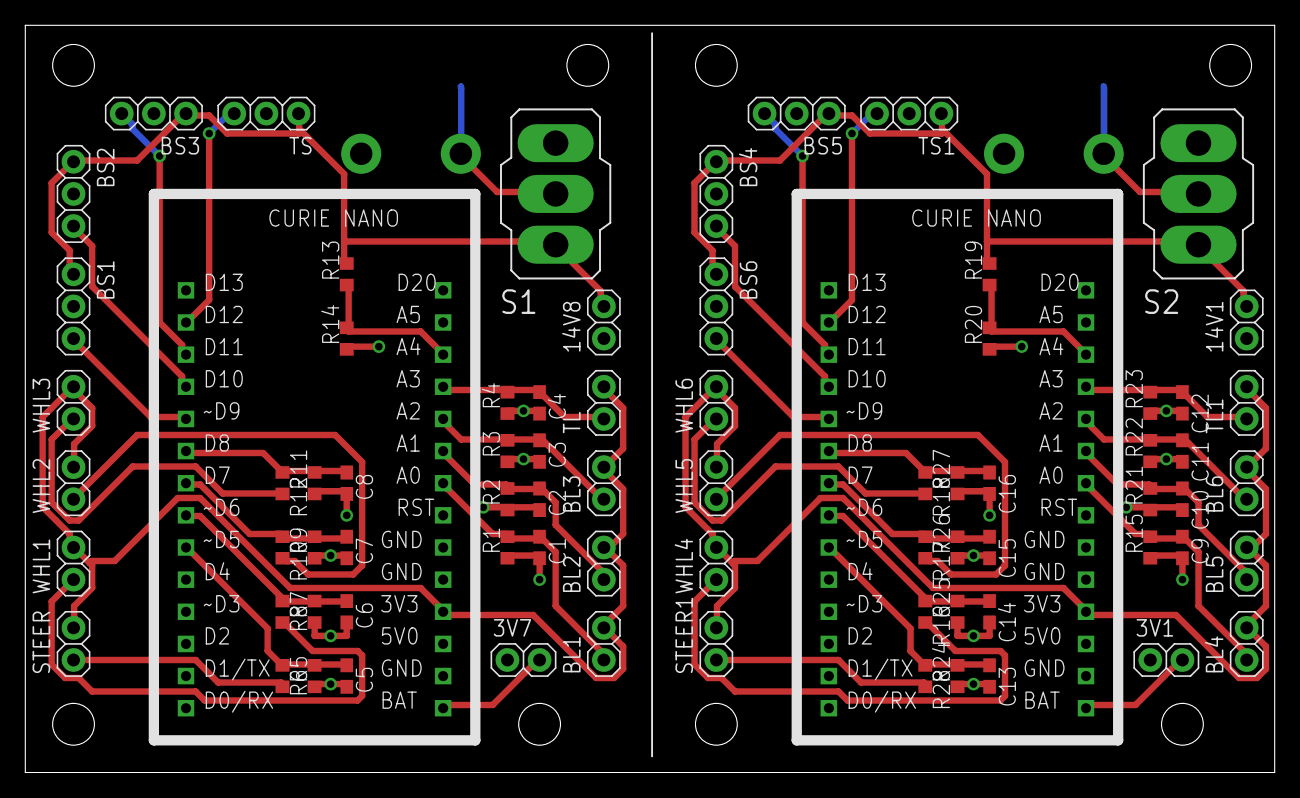
[picture p47: board boarddoubled.brd from above]

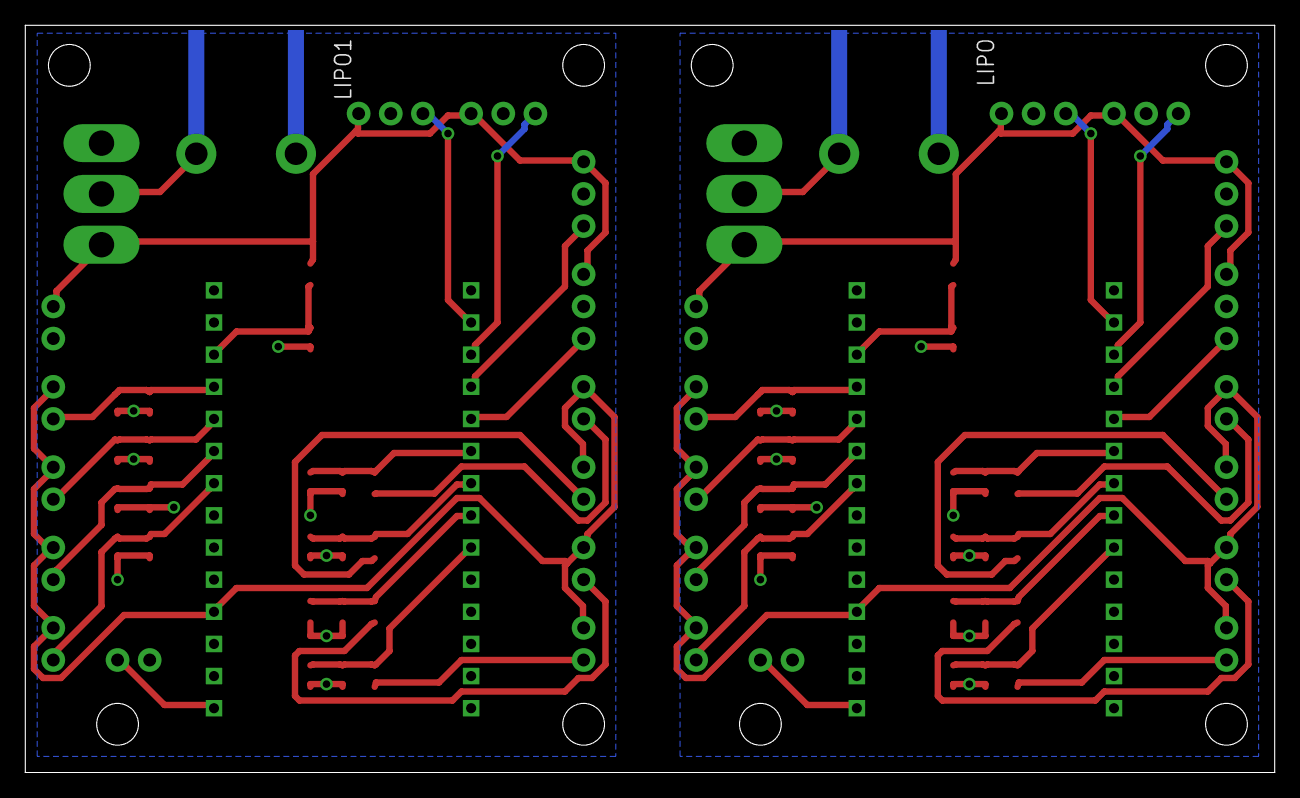
[picture p48: board boarddoubled.brd from below]

Board: 2 copper layers, 98.7 x 59.0 mm, 86 parts (2 on the bottom side), 44 nets.

Parts:
3V1, 3V7, 14V1, 14V8: 1X02
BL1, BL2, BL3, BL4, BL5, BL6: 1X02
BS1, BS2, BS3, BS4, BS5, BS6: 1X03
C1, C2, C3, C4, C9, C10, C11, C12: 0.1u; C0603
C5, C6, C7, C8, C13, C14, C15, C16: 1n; C0603
JP1, JP2, JP3, JP4, JP13, JP14, JP15, JP16: STAND-OFF
LIPO, LIPO1: ANDERSONHORIZONTAL; ANDERSON_HORIZONTAL
R1, R2, R3, R4, R15, R21, R22, R23: 5.1k; R0603
R5, R7, R9, R11, R24, R25, R26, R27: 10k; R0603
R6, R8, R10, R12, R16, R17, R18, R28: 1k; R0603
R13, R19: 10K; R0603
R14, R20: 1K; R0603
S1, S2: 320-916
STEER, STEER1: 1X02
TL, TL1: 1X02
TS, TS1: 1X03
U$1, U$2: CURIENANO_BREAKOUT; CURIENANO
WHL1, WHL2, WHL3, WHL4, WHL5, WHL6: 1X02

Connections:
3V1: 3V1.2, U$2.BAT
3V2: BL4.2, BL5.2, BL6.2, STEER1.2, TL1.2, U$2.3V3, WHL4.2, WHL5.2, WHL6.2
3V3: BL1.2, BL2.2, BL3.2, STEER.2, TL.2, U$1.3V3, WHL1.2, WHL2.2, WHL3.2
3V7: 3V7.2, U$1.BAT
14V1: 14V1.2, BS4.1, BS5.1, BS6.1, R19.2, S2.1, TS1.1
14V8: 14V8.2, BS1.1, BS2.1, BS3.1, R13.2, S1.1, TS.1
BAT_CHECK: R13.1, R14.2, U$1.A4
BAT_CHECK1: R19.1, R20.2, U$2.A4
BRAKE_P1: BL1.1, C1.1, R1.2, U$1.A0
BRAKE_P2: BL2.1, C2.1, R2.2, U$1.A1
BRAKE_P3: BL3.1, C3.1, R3.2, U$1.A2
BRAKE_P4: BL4.1, C9.1, R15.2, U$2.A0
BRAKE_P5: BL5.1, C10.1, R21.2, U$2.A1
BRAKE_P6: BL6.1, C11.1, R22.2, U$2.A2
BRAKE_PWM1: BS1.3, U$1.~D9
BRAKE_PWM2: BS2.3, U$1.D10
BRAKE_PWM3: BS3.3, U$1.D11
BRAKE_PWM4: BS5.3, U$2.D11
BRAKE_PWM5: BS4.3, U$2.D10
BRAKE_PWM6: BS6.3, U$2.~D9
GND: 3V7.1, 14V8.1, BS1.2, BS2.2, BS3.2, C1.2, C2.2, C3.2, C4.2, C5.2, C6.2, C7.2, C8.2, LIPO.PIN1, LIPO.PIN1-LEAD, R1.1, R2.1, R3.1, R4.1, R5.1, R7.1, R9.1, R11.1, R14.1, TS.2, U$1.GND3
GND1: 3V1.1, 14V1.1, BS4.2, BS5.2, BS6.2, C9.2, C10.2, C11.2, C12.2, C13.2, C14.2, C15.2, C16.2, LIPO1.PIN1, LIPO1.PIN1-LEAD, R15.1, R20.1, R21.1, R22.1, R23.1, R24.1, R25.1, R26.1, R27.1, TS1.2, U$2.GND3
unnamed: R6.2, STEER.1
unnamed: R8.2, WHL1.1
unnamed: R10.2, WHL2.1
unnamed: R12.2, WHL3.1
unnamed: LIPO.PIN2, LIPO.PIN2-LEAD, S1.2
unnamed: R28.2, STEER1.1
unnamed: R16.2, WHL4.1
unnamed: R17.2, WHL5.1
unnamed: R18.2, WHL6.1
unnamed: LIPO1.PIN2, LIPO1.PIN2-LEAD, S2.2
STEERING_P: C5.1, R5.2, R6.1, U$1.~D5
STEERING_P1: C13.1, R24.2, R28.1, U$2.~D5
TILT_P: C4.1, R4.2, TL.1, U$1.A3
TILT_P1: C12.1, R23.2, TL1.1, U$2.A3
TILT_PWM: TS.3, U$1.D12
TILT_PWM1: TS1.3, U$2.D12
WHEEL_P1: C6.1, R7.2, R8.1, U$1.~D6
WHEEL_P2: C7.1, R9.2, R10.1, U$1.D7
WHEEL_P3: C8.1, R11.2, R12.1, U$1.D8
WHEEL_P4: C16.1, R18.1, R27.2, U$2.D8
WHEEL_P5: C15.1, R17.1, R26.2, U$2.D7
WHEEL_P6: C14.1, R16.1, R25.2, U$2.~D6
