CollinYan/HPV-2017-EE/PCB/Arduino101/board1.brd

## EAGLE design PCB/Arduino101/board1.brd (2018-02-22)

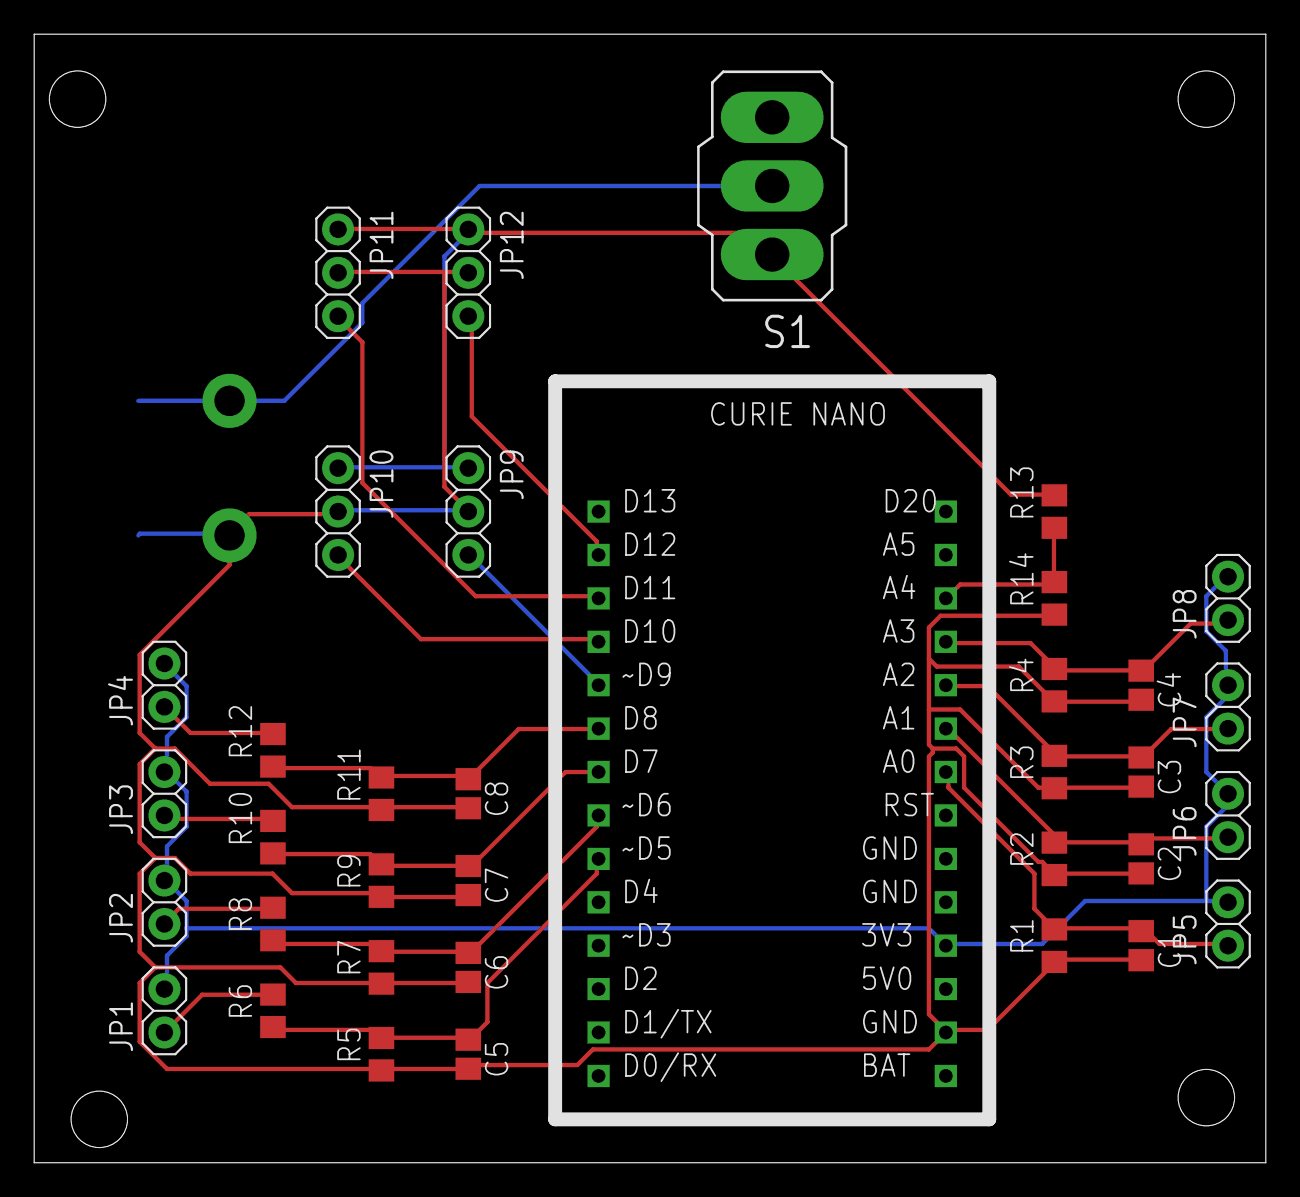
[picture p49: board PCB/Arduino101/board1.brd from above]

Board: 2 copper layers, 72.1 x 66.0 mm, 41 parts (1 on the bottom side), 21 nets.

Parts:
C1, C2, C3, C4: 0.1u; C0805
C5, C6, C7, C8: 1n; C0805
CONN1: ANDERSONHORIZONTAL; ANDERSON_HORIZONTAL
JP1, JP2, JP3, JP4, JP5, JP6, JP7, JP8: 1X02
JP9, JP10, JP11, JP12: 1X03
JP13, JP14, JP15, JP16: STAND-OFF
R1, R2, R3, R4: 5.1k; R0805
R5, R7, R9, R11: 10k; R0805
R6, R8, R10, R12: 1k; R0805
R13: 10K; R0805
R14: 1K; R0805
S1: 320-916
U$1: CURIENANO_BREAKOUT; CURIENANO

Connections:
3V3: JP1.2, JP2.2, JP3.2, JP4.2, JP5.2, JP6.2, JP7.2, JP8.2, U$1.3V3
14V8: JP9.1, JP10.1, JP11.1, JP12.1, R13.2, S1.1
BAT_CHECK: R13.1, R14.2, U$1.A4
BRAKE_P1: C1.1, JP5.1, R1.2, U$1.A0
BRAKE_P2: C2.1, JP6.1, R2.2, U$1.A1
BRAKE_P3: C3.1, JP7.1, R3.2, U$1.A2
BRAKE_PWM1: JP9.3, U$1.~D9
BRAKE_PWM2: JP10.3, U$1.D10
BRAKE_PWM3: JP11.3, U$1.D11
GND: C1.2, C2.2, C3.2, C4.2, C5.2, C6.2, C7.2, C8.2, CONN1.PIN1, CONN1.PIN1-LEAD, JP9.2, JP10.2, JP11.2, JP12.2, R1.1, R2.1, R3.1, R4.1, R5.1, R7.1, R9.1, R11.1, R14.1, U$1.GND3
unnamed: JP1.1, R6.2
unnamed: JP2.1, R8.2
unnamed: JP3.1, R10.2
unnamed: JP4.1, R12.2
unnamed: CONN1.PIN2, CONN1.PIN2-LEAD, S1.2
STEERING_P: C5.1, R5.2, R6.1, U$1.~D5
TILT_P: C4.1, JP8.1, R4.2, U$1.A3
TILT_PWM: JP12.3, U$1.D12
WHEEL_P1: C6.1, R7.2, R8.1, U$1.~D6
WHEEL_P2: C7.1, R9.2, R10.1, U$1.D7
WHEEL_P3: C8.1, R11.2, R12.1, U$1.D8
