CollinYan/HPV-2017-EE/Code/controller_comp/controller_comp.ino

//#include <PID_v1.h>
#include "Servo.h"
#include "AnalogSmoothInt.h"
#include "ParkingLock.h"
#include "WheelSpeed.h"
#include "AccelSpeed.h"
#include "CurieTimerOne.h"
#include "AntiLockBrake.h"

// Comment the following statement to disable logging on serial port.
#define SERIAL_PORT_LOG_ENABLE 1

unsigned long start_time = 0;
unsigned long end_time = 0;

/*pins*/
const int batteryPin = A4;    // Battery voltage divided down by 10
const int brakePin1 = A0;     // Braking input: ranges from min value to max value, should convert to servo value 0-180 deg
const int brakePin2 = A1;     // Braking input: ranges from min value to max value, should convert to servo value 0-180 deg
const int brakePin3 = A2;
const int tiltPin = A3;       // Tilt lever input: ranges from the same values as potpin
const int brakePWMPin1 = 9;   // Output to the brake servo for front wheel
const int brakePWMPin2 = 10;   // Output to the brake servo for rear left wheel
const int brakePWMPin3 = 11;   // Output to the brake servo for rear right wheel
const int tiltPWMPin = 12;     // Output to the tilt lock servo
const int16_t wheel1Pin = 6;                    //digitalRead pin
const int16_t wheel2Pin = 7;                     //digitalRead pin
const int16_t wheel3Pin = 8;                     //digitalRead pin

/*Timing*/
const int periodBrakeRead = 10;             //period of brake input interrupt reading in ms
boolean leverReadTicked = 0;                //keep track of whether brake was read
const int periodServoWrite = 50;
boolean servoWriteTicked = 0;                //keep track of whether brake was read
const int periodAccelRead = 10;             //period of brake input interrupt reading in ms
boolean accelReadTicked = 0;                //keep track of whether brake was read


/*battery*/
const int batteryVoltageCutoff = 3.6*4/3.3*1023/9.18;  //
int batteryVoltage;
bool batteryGood;

/*LEVERS AND SERVOS variables*/
const int minValue = 2.380 * 1023/3.3;      //1.1V to 1.2V or 2.38V to 2.93V depending on potentiometer position
const int maxValue = 2.930 * 1023/3.3;
const int minHighTime = 800;                //min High time for PWM to servo, according to specs
const int maxHighTime = 2200;               //max High time for PWM to servo, according to specs
const int minServoRange = 90;              //0 degrees would output minHighTime
const int maxServoRange = 175;              //180 degrees would ouput maxHighTime
float brakeRead1;                     // value read in from brake lever after being smoothed
float brakeRead2;                     // value read in from brake lever after being smoothed
float tiltRead;                             // value read in from tilt lever after being smoothed
int brakeServoOutput1;                      // servo output for brake
int brakeServoOutput2;                      // servo output for brake
int brakeServoOutput3;                      // servo output for brake
int tiltServoOutput;                        // servo output for tiltlock
int brakeServoOutputProcessed1;             // after processed for locking
int brakeServoOutputProcessed2;             // after processed for locking
int brakeServoOutputProcessed3;             // after processed for locking
int tiltServoOutputProcessed;               // after processed for locking

/*For smoothing break input*/
AnalogSmoothInt smoothedBrake1 = AnalogSmoothInt(5);
AnalogSmoothInt smoothedBrake2 = AnalogSmoothInt(5);
AnalogSmoothInt smoothedBrake3 = AnalogSmoothInt(5);
AnalogSmoothInt smoothedTilt = AnalogSmoothInt(5);

/*Parking lock*/
const int lockingTime = 2000;               //ms until levers lock
const int lockingTol = 9;                   //tolerance for lever values to lock
ParkingLock brakeLock1 = ParkingLock(1000/periodBrakeRead,lockingTime, lockingTol);
ParkingLock tiltLock = ParkingLock(1000/periodBrakeRead,lockingTime, lockingTol);

/*Servo Objects*/
Servo brakeServo1;
Servo brakeServo2;
Servo brakeServo3;
Servo tiltServo;

/*Wheel Speed*/
const int rollout1 = 2136;                              //circumference of front wheel in mm 2117 loaded harrison's tire, 2146, unloaded harrison's tire
const int rollout2 = 2136;                               //circumference of rear left wheel in mm
const int rollout3 = 2136;                               //circumference of rear right wheel in mm
const int magnets1 = 8;                                     //# of magnets on front wheel
const int magnets2 = 16;                                      //# of magnets on rear left wheel
const int magnets3 = 16;                                      //# of magnets on rear right wheel
const int minSpeed = 5;                                     //minSpeed in mph

WheelSpeed wheel1(rollout1, magnets1, minSpeed);
WheelSpeed wheel2(rollout2, magnets2, minSpeed); 
WheelSpeed wheel3(rollout2, magnets3, minSpeed); 
AnalogSmoothInt smoothedWheel1 = AnalogSmoothInt(1);
AnalogSmoothInt smoothedWheel2 = AnalogSmoothInt(1);
AnalogSmoothInt smoothedWheel3 = AnalogSmoothInt(1);

/* Accel Speed */
const int freq = 100;
const float scale = .87;           // 1/cos(3degrees) = 1.001372
const int timePeriod = 10000;           // frequency that timer will update (1000 microseconds = .001 sec) //Hchaged to 10ms for now
AccelSpeed myAccelSpeed(freq, scale);         // create AccelSpeed object with some frequency //change to 100Hz
// 1 mi/h -> 100 , right now is m/s
int accelIndice;
boolean braking = true;

/* Anti Lock Brake */
const double kP = 0.02;
const double kI = 0.06;
const double kD = 0;//0.01/20 since 5000 slip 50% diff would cause 0.01*5000 / 20 less brake output which is 50 degrees, rails at min(90) + 40 = 130 at first.;
double maxSlipPercX100 = 900;
double latestInput1 = minServoRange;
double slip2 = 0;

/* Anti Lock Brake PID Library*/
//PID wheel1PID(&slip2, &latestInput1, &maxSlipPercX100, kP, kI, kD, DIRECT);
  
void setup() {
  brakeServo1.attach(brakePWMPin1,minHighTime,maxHighTime);
  brakeServo2.attach(brakePWMPin2,minHighTime,maxHighTime);
  brakeServo3.attach(brakePWMPin3,minHighTime,maxHighTime);
  tiltServo.attach(tiltPWMPin,minHighTime,maxHighTime);

  /*Wheel speed*/
  attachInterrupt(digitalPinToInterrupt(wheel1Pin), wheel1UpISR, RISING);
  attachInterrupt(digitalPinToInterrupt(wheel2Pin), wheel2UpISR, RISING);
  attachInterrupt(digitalPinToInterrupt(wheel3Pin), wheel3UpISR, RISING);

//  wheel1PID.SetMode(AUTOMATIC);
//  wheel1PID.SetSampleTime(45); //slower than brake actuation so we dont have delay
//  wheel1PID.SetOutputLimits((maxServoRange-minServoRange)*0.73+minServoRange, maxServoRange);

  Serial.begin(9600);
  Serial.println("-- initialized --");
}

void loop() {
  //start_time = micros();
  checkBat(); //checks battery voltage and sets batteryGood
  if (batteryGood) {
    readLever();
    wheelSpeed();
//    accelSpeed();
    brake();
  } else {
    Serial.println("low bat!!");
    Serial.println(batteryVoltage);
    Serial.println(batteryVoltageCutoff);
  }
  /*
  end_time = micros();
  Serial.print("Start time: ");
  Serial.println(start_time);
  Serial.print("End time: ");
  Serial.println(end_time);
  Serial.print("Elapsed time: ");
  Serial.println(end_time - start_time);
  */
}
