CollinYan/HPV-2017-EE/Code/controllerCompBasic/wheelSpeedFuncs.ino

/*continuous*/
void wheelSpeed() {
  if (wheel1._interruptedUp) {
    wheel1.updateSpeed();
    //Serial.println('1');
    wheel1._mphX100 = smoothedWheel1.smooth(wheel1._mphX100);
  }
  if (wheel2._interruptedUp) {  
    wheel2.updateSpeed();
    wheel2._mphX100 = smoothedWheel2.smooth(wheel2._mphX100);
    //Serial.println('2');
  }
  if (wheel3._interruptedUp) {
    wheel3.updateSpeed();
    wheel3._mphX100 = smoothedWheel3.smooth(wheel3._mphX100);
    //Serial.println('3');
  }
  if (millis() % (wheel2._maxTime/5000) == 0) {     //check 5x the period for zerospeed
    wheel1.zeroMPH();
    wheel2.zeroMPH();
    wheel3.zeroMPH();
  }
}

/*external interrupts*/
void wheel1UpISR() {
  wheel1.readTimeUp();
}
void wheel2UpISR() {
  wheel2.readTimeUp();
}
void wheel3UpISR() {
  wheel3.readTimeUp();
}
