CollinYan/HPV-2017-EE/Code/controller_comp/absFuncs.ino

/*called by brake which is 10Hz*/
/*void antiLockBrake() {
  int msTick = wheel2._centerToCenter/1000;
  accelIndice = myAccelSpeed._arrayPos-msTick/(1000/freq);
  if (accelIndice < 0) {
    accelIndice += 10;
  }
  if (1) {
  //if (myAccelSpeed._mphX100[accelIndice] < (minSpeed*1.5)*100 || !braking) {
    wheel1PID.SetMode(MANUAL);
    latestInput1 = brakeServoOutputProcessed1;
  } else {
    wheel1PID.SetMode(AUTOMATIC);
    //slip2 = (myAccelSpeed._mphX100[accelIndice] - wheel2._mphX100)/myAccelSpeed._mphX100[accelIndice]*10000;
    slip2 = (float)(wheel1._mphX100 - wheel2._mphX100)/wheel1._mphX100*10000;
  }

}*/
