CollinYan/HPV-2017-EE/Code/controllerBasic/accelSpeedFuncs.ino

/*continuous*/
void accelSpeed() {
  /*
  if (myAccelSpeed._interrupted) {
    myAccelSpeed.updateSpeed(0, braking);    // placeholders for wheelspeed and braking
  }
  */
}

/*100Hz*/
/*
void timedUpdateSpeedISR() {
  myAccelSpeed.setAccel();
}
*/
