CollinYan/HPV-2017-EE/(commit log)

2018-01-30 collin is the best
    [30 and 40 kp values.xlsx, 8.5mm socket v3(1).iges, Assem2.STEP, Body1.stl, back to 2khz and front wheel.csv, barrel adjuster repalcemetn.stl, bottom smooth hook adaptor.stl, cable attach.STEP]
2018-02-03 Added auto tilt lock and brake servo outputs
2018-02-03 added servo.h and a couple lines
2018-02-03 arduino ide asked me to save...
2018-02-03 fixed convertToServo func int/double issue
    [funcs.ino]
2018-02-04 added serial print statements
2018-02-06 change pins and variable names for brake and tilt and added block diagram docx
2018-02-06 added constraint to servo angle to protect it
2018-02-09 moved array deque out of controller since it didnt compile, added smoothing and actualy servo values for current setup, need to make smoothing a library instead
    [Brake Lever L1.stl, Brake Lever L2.stl, Brake Lever R1.stl, Brake Lever R2.stl, Enclosure Lid.stl, Enclosure.stl, brake lever p1.stl, brake lever p2.stl]
2018-02-09 changed for larger window for noise and made smoothing actualy return a float
    [controller.ino, funcs.ino]
2018-02-09 increased smoothing to 10 samples so 50ms, but still very noisy, need to fix noise either hardware or more software averagin, also locks onto 75 when minimum is 70, causing excess power draw since it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
    [controller.ino, funcs.ino]
2018-02-09 increase sampling freq so we can smooth more values but we should decrease actuation frequency back to around 200hz later. also implemented quick fix for locking into minimum position as it was locki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
    [controller.ino, funcs.ino]
2018-02-12 updated locking to lock to current position instead of lock-4, both should save batttery. also decreased frequency and averaging count since we made the hardware have higher resolution
2018-02-20 cleaned up controller code and increased smoothing to 5 samples which corresponds to 50ms
2018-02-20 typos in last commit and adding condition for checking magnets
2018-02-20 setting up 1khz interrupt for wheel speed
2018-02-21 pcb for arduino curienano breakout
    [board1.sch]
2018-02-22 schematic v1 and layed out components
    [board1.brd, board1.sch]
2018-02-22 laayed out smaller 0603 pakcages, need to smash values
    [board1.brd, board1.sch]
2018-02-22 renamed jumpers and connectors
    [board1.brd, board1.sch]
2018-02-22 added buck converter
    [board1.brd]
2018-02-22 finshed routing, made a board with duplicate, need to check anderson
    [board1.sch, boarddoubled.brd, braking force.xlsx, braking force2.xlsx, pulsing break with nonlineariity.xlsx, servo current vs position.xlsx]
2018-02-22 submitted ersion of gerber to bac
    [boarddoubled.brd]
2018-02-23 cleaned up wheelspeed code to compile for curienano but will next get ride of debounce and useless stuff
2018-02-23 organized wheelspeed and no debounce
2018-02-24 changed wheelspeed to use external interrupts, stil l with rising and falilng edge, will changed to rising only
2018-02-24 cleaned up accelSpeed and edited some structure in controler to impelment wheel and accel speed and abs
2018-02-26 excel for wheel speed error calcs, and changed brake freq to 20hz
    [digitization error wheel magnet ticks.xlsx]
2018-02-27 tested wheelspeed, added debounce
    [data.xlsx]
2018-02-27 working prototype version testing on bike
    [buck converter enclosure lid.stl, buck converter enclosure.stl]
2018-02-27 reduced code in wheel interrupt and updates, need to test speed
2018-02-27 added timgin code for wheelseped and controller
    [data.xlsx]
2018-02-28 changed condition for reading brake lever so doesnt have to be exaclt at the ms
2018-02-28 wheelspeed constant has issue giving 0mph, breaking working at speed now
    [WheelSpeed.cpp, WheelSpeed.ino, controllerBasic.ino, leverAndServoFuncs.ino, wheelSpeedFuncs.ino]
2018-02-28 made copy into controller, ready for accel and pid
2018-03-01 changed units issues with wheelspeed mph and added calibrationg when initializing accelerometer
    [AccelSpeed.cpp, AccelSpeed.h, AccelSpeed.ino, WheelSpeed.cpp]
2018-03-01 updated wheelspeed library
2018-03-02 deleted unneede variable in accelspeed freom testing
    [bottom horn adaptor.stl, magnet holder.stl, top horn adaptor.stl]
2018-03-02 fixed compil erros in wheelspeed
    [ABS.cpp, ABS.h, WheelSpeed.cpp, WheelSpeed.h, absFuncs.ino]
2018-03-02 wheelspeed working
2018-03-02 changed unit issues, got data, need to add accel compensation constant
    [accel v and wheel v comparison.xlsx]
2018-03-03 added fixaround for accel, added p contorller
    [offset magnet.stl]
2018-03-03 fixed accelspeed unit conversion & renamed vehicleSpeed to mphX100
    [AccelSpeed.cpp, AccelSpeed.h]
2018-03-04 updated wheelspeed to calc mphX100 instead of mphX10
2018-03-04 copied wheelspeed folder into library
2018-03-04 fixed AccelSpeed constructor, int/float freq
    [AccelSpeed.h, controller.ino]
2018-03-04 fixed wheelspeed scaling
2018-03-04 wheelspeed redo scaling
2018-03-04 was off by factor of ten for center space calc wheelspeed
2018-03-06 v2 pcb, code for pid, data for pid on bike
    [accel v and wheel v comparison 2.csv, board1.brd, board1.sch, calculating frequency of speed updates.xlsx, data pid.xlsx]
2018-03-07 cleaned up code and pid
2018-03-07 changed from brakeServoOutput1 to brakeServoOutput2
2018-03-07 trying to fix controller pid
    [absFuncs.ino, leverAndServoFuncs.ino]
2018-03-07 debugging pid with print, change manual and auto modes for pid when under speed lim
2018-03-08 pid workingbetter neeed to tune pi
    [data pid Wed March 7 2018.xlsx]
2018-03-09 equal performance with skid
    [accel v and wheel v comparison 2.csv, brakePIDMarch8.xlsx, brakePIDMarch8Slip8kP0.02kI0.06kD0.csv, brakePIDMarch8Slip8kP0.02kI0.06kD0min50.csv, brakePIDMarch8Slip8kP0.02kI0.06kD0min70.csv, brakePIDMarch8kP0.005kI0.05kD0.05.csv, brakePIDMarch8kP0.005kI0.05kD0.csv, brakePIDMarch8kP0.01kI0.05kD0.05.csv]
2018-03-09 much better than manual
    [brakePIDMarch8ManualDampLock.csv, brakePIDMarch8ManualSmart.csv, brakePIDMarch8Slip8.5kP0.02kI0.06kD0min70.csv, brakePIDMarch8Slip8.5kP0.02kI0.06kD0min73.csv, brakePIDMarch8Slip8.5kP0.02kI0.06kD0min73Maybedifferent.csv, brakePIDMarch8Slip8.9kP0.02kI0.06kD0min70.csv]
2018-03-09 file for less traces only vel matlab
2018-03-20 stuff used for innovation video
    [brakePIDMarch9Manual.csv, brakePIDMarch9ManualSmart.csv, brakePIDMarch9Slip8.5kP0.02kI0.06kD0min73.csv, brakePIDMarch9Slip9kP0.02kI0.06kD0min73.csv]
