CollinYan/HPV-2017-EE/pics/20171104_145913.jpg

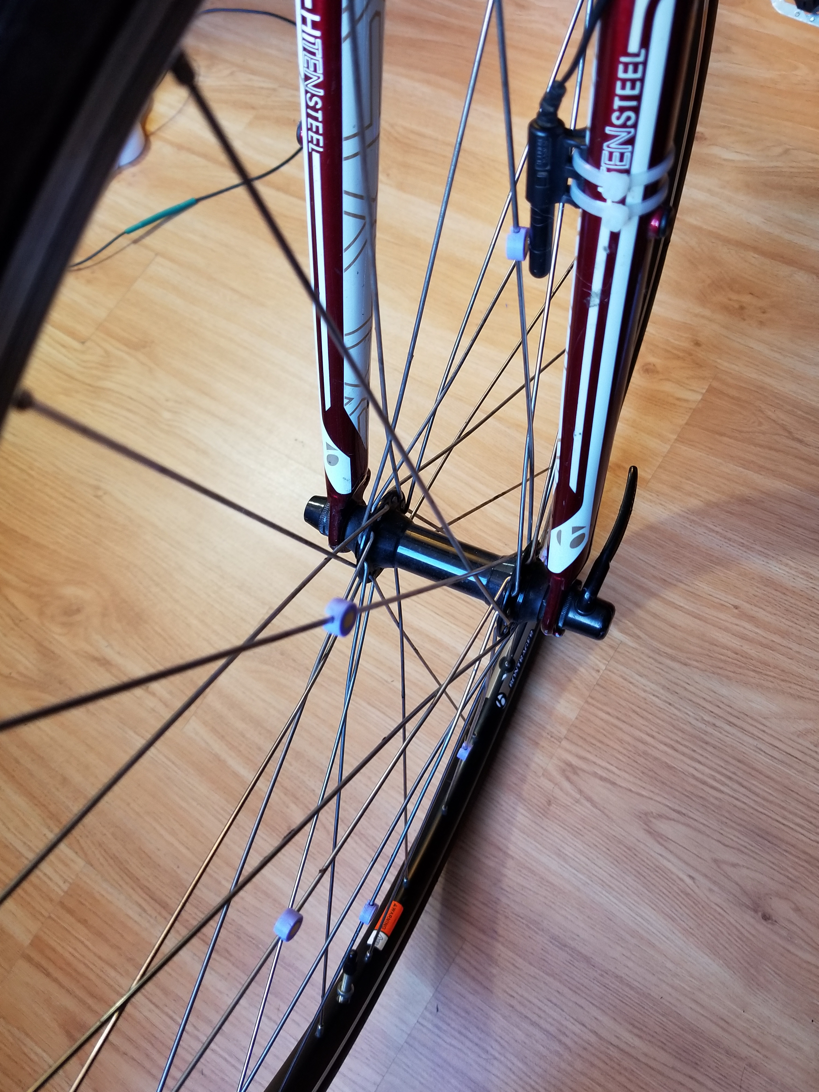
pics/20171104_145913.jpg
